GoodByte-Hardware/BTZ-EndDevice/kibot_resources/templates/readme.txt

<p align="center" width="100%">
  
</p>

<h1 align="center">${BOARD_NAME}</h1>

<p align="center" width="100%">
  <a href="${GIT_URL}/actions/workflows/ci.yaml">
    CI Badge
  </a>
</p>

***

<p align="center">
  3D Top Angled
&nbsp; &nbsp; &nbsp; &nbsp;
  3D Bottom Angled
</p>

***

## SPECIFICATIONS

| Parameter | Value | 
| --- | --- |
| Dimensions | ${bb_w_mm} × ${bb_h_mm} mm |

***

## DIRECTORY STRUCTURE

    .
    ├─ HTML               # HTML files for generated webpage
    ├─ Images             # Pictures and renders
    │
    ├─ kibot_resources    # External resources for KiBot
    │  ├─ colors          # Color theme for KiCad
    │  ├─ fonts           # Fonts used in the project
    │  ├─ scripts         # External scripts used with KiBot
    │  └─ templates       # Templates for KiBot generated reports
    │
    ├─ kibot_yaml         # KiBot YAML config files
    ├─ KiRI               # KiRI (PCB diff viewer) files
    │
    ├─ Library         	  # KiCad footprint and symbol libraries
    │  ├─ 3D Model       # Component 3D models
    │  ├─ Footprint      # Footprint libraries
    │  └─ Symbol         # Symbol libraries
    │
    ├─ Logos              # Logos
    │
    ├─ Manufacturing      # Assembly and fabrication documents
    │  ├─ Assembly        # Assembly documents (BoM, pos, notes)
    │  │
    │  └─ Fabrication     # Fabrication documents (ZIP, notes)
    │     ├─ Drill Tables # CSV drill tables
    │     └─ Gerbers      # Gerbers
    │
    ├─ Report             # Reports for ERC/DRC
    ├─ Schematic          # PDF of schematic
    ├─ Templates          # Title block templates
    ├─ Testing
    │  └─ Testpoints      # Testpoints tables      
    │
    └─ Variants           # Outputs for assembly variants
