GoodByte-Hardware/BTZ-EndDevice/HTML/images/cat_pdf_drill_map_BTZ-EndDevice-NPTH_drill_map.png

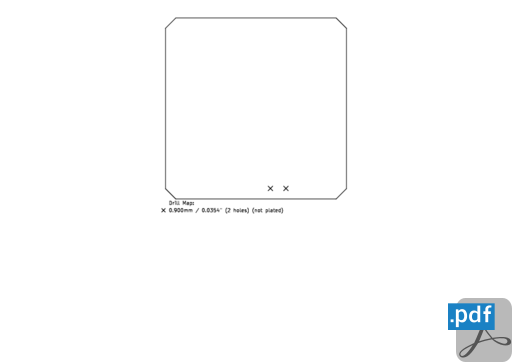
HTML/images/cat_pdf_drill_map_BTZ-EndDevice-NPTH_drill_map.png
