GoodByte-Hardware/BTZ-EndDevice/HTML/images/cat_pdf_schematic_BTZ-EndDevice-schematic.png

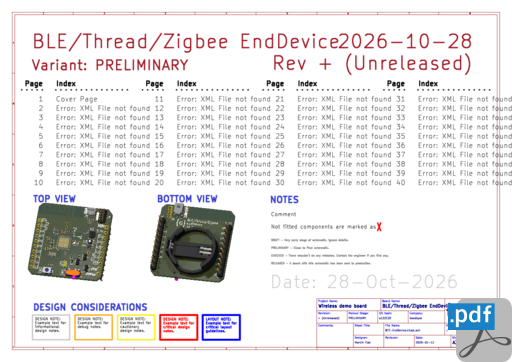
HTML/images/cat_pdf_schematic_BTZ-EndDevice-schematic.png
