GoodByte-Hardware/BTZ-EndDevice/HTML/images/cat_png_3d_viewer_bottom_BTZ-EndDevice-bottom.png

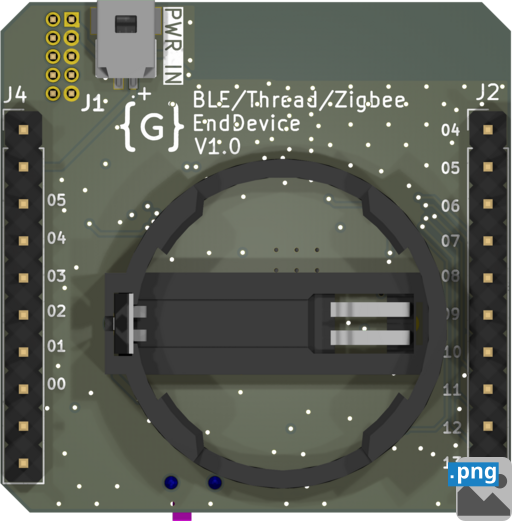
HTML/images/cat_png_3d_viewer_bottom_BTZ-EndDevice-bottom.png
