GoodByte-Hardware/BTZ-EndDevice/HTML/images/cat_png_3d_viewer_top_BTZ-EndDevice-top.png

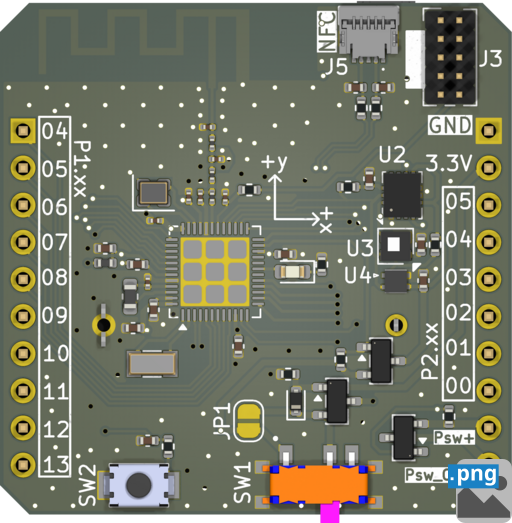
HTML/images/cat_png_3d_viewer_top_BTZ-EndDevice-top.png
