GoodByte-Hardware/BTZ-EndDevice/Manufacturing/Assembly/BTZ-EndDevice-bom.html

 | Bill of Materials
 | Schematic: BTZ-EndDevice Variant: PRELIMINARY Revision: + (Unreleased) Date: 2025-01-12 KiCad Version: 9.0.7+1 | Component Groups: 33 Component Count: 50 (per PCB) Fitted Components: 50 (per PCB) Number of PCBs: 1 Total Components: 50 (for 1 PCBs)
Row | Quantity Per PCB | References | Value | Datasheet | Footprint | Description | Manufacturer | Manufacturer Part Number | Supplier Part Number
1 | 1 | C12 | 0.3pF | ~ | C_0201_0603Metric | Unpolarized capacitor
2 | 1 | C11 | 2pF | ~ | C_0201_0603Metric | Unpolarized capacitor
3 | 1 | C10 | 1,5pF | ~ | C_0201_0603Metric | Unpolarized capacitor
4 | 1 | C14 | 3,9pF | ~ | C_0201_0603Metric | Unpolarized capacitor
5 | 2 | C17 C19 | 300pF | ~ | C_0402_1005Metric | Unpolarized capacitor
6 | 2 | C7 C18 | 10nF | ~ | C_0402_1005Metric | Unpolarized capacitor
7 | 1 | C6 | 2,2nF | ~ | C_0201_0603Metric | Unpolarized capacitor
8 | 7 | C2 C3 C4 C5 C13 C15 C16 | 100nF | ~ | C_0402_1005Metric | Unpolarized capacitor
9 | 1 | C1 | 10μF | ~ | C_0402_1005Metric | Unpolarized capacitor
10 | 2 | C8 C9 | 2,2μF | ~ | C_0402_1005Metric | Unpolarized capacitor
11 | 1 | D1 | D_Schottky | ~ | D_SOD-523 | Schottky diode
12 | 1 | D2 | LED | ~ | LED_0603_1608Metric | Light emitting diode
13 | 1 | FB1 | 120R@100MHz | ~ | L_0402_1005Metric | Ferrite bead
14 | 2 | J1 J3 | Conn_01x02_MountingPin | ~ | 2035580207 | Generic connectable mounting pin connector, single row, 01x02, script generated (kicad-library-utils/schlib/autogen/connector/) Cortex Debug Connector, standard ARM Cortex-M SWD and JTAG interface |  | A1001WR-S-2P
15 | 1 | J5 | Conn_01x05_MountingPin | ~ | 59453051110ECHLF | Generic connectable mounting pin connector, single row, 01x05, script generated (kicad-library-utils/schlib/autogen/connector/) | Amphenol FCI | 59453-051110ECHLF
16 | 1 | L2 | 2,7nH | ~ | L_0201_0603Metric | Inductor
17 | 2 | L3 L4 | 3,5nH | ~ | L_0201_0603Metric | Inductor
18 | 1 | L1 | 4,7μH | ~ | L_0603_1608Metric | Inductor
19 | 3 | Q1 Q2 Q3 | AO3401A | http://www.aosmd.com/pdfs/datasheet/AO3401A.pdf | SOT-23 | -4.0A Id, -30V Vds, P-Channel MOSFET, SOT-23
20 | 2 | R8 R10 | 0R | ~ | R_0402_1005Metric | Resistor
21 | 2 | R6 R9 | 1k | ~ | R_0402_1005Metric | Resistor
22 | 2 | R4 R5 | 10k | ~ | R_0402_1005Metric | Resistor
23 | 1 | R3 | 3,3k | ~ | R_0402_1005Metric | Resistor
24 | 2 | R1 R7 | 470k | ~ | R_0402_1005Metric | Resistor
25 | 1 | R2 | 1M | ~ | R_0402_1005Metric | Resistor
26 | 1 | SW1 | SW_SPDT | ~ | SSSS810701 | Switch, single pole double throw
27 | 1 | SW2 | SW_SPST | ~ | SW_TS-1088-AR02016 | Single Pole Single Throw (SPST) switch
28 | 1 | U2 | BMI270 | https://www.bosch-sensortec.com/media/boschsensortec/downloads/datasheets/bst-bmi270-ds000.pdf | Bosch_LGA-14_3x2.5mm_P0.5mm | 6-axis, smart, low power Inertial Measurement Unit
29 | 1 | U4 | LTR-329ALS-01 | https://optoelectronics.liteon.com/upload/download/DS86-2014-0006/LTR-329ALS-01_DS_V1.pdf | Lite-On_LTR-329ALS-01 | ambient light sensor, i2c interface, 0.01 to 64k lux, 2.4-3.6V | Lite-On | LTR-329ALS-01
30 | 1 | U3 | STS4X | https://sensirion.com/media/documents/D2D0B4A9/67AA0F30/HT_DS_Datasheet_STS4x.pdf | STS4X | Digital Temperature Sensor, ±0.2 °C, Ultra-Low-Power, I2C fast mode plus
31 | 1 | U1 | nRF54L15-QFXX | https://docs.nordicsemi.com/bundle/ps_nrf54L15 | QFN-48-1EP_6x6mm_P0.4mm_EP4.6x4.6mm | nRF54L Dual Core Multiprotocol BLE SoC
32 | 1 | Y2 | 32.768kHz | ~ | Crystal_SMD_3215-2Pin_3.2x1.5mm | Two pin crystal
33 | 1 | Y1 | 32MHz | ~ | Crystal_SMD_2016-4Pin_2.0x1.6mm | Four pin crystal, GND on pins 2 and 4
Color reference for columns:
KiCad Fields (default)
Generated Fields
User Fields
Empty Fields
