GoodByte-Hardware/BTZ-EndDevice/Manufacturing/Assembly/BOM_V1.0.csv

Reference | Value | Footprint | LCSC
C4 | 100nF | Capacitor_SMD:C_0201_0603Metric | C76939
C6 | 2,2nF | Capacitor_SMD:C_0201_0603Metric | C161488
C9 | 2,2μF | Capacitor_SMD:C_0201_0603Metric | C335106
C10 | 1,5pF | Capacitor_SMD:C_0201_0603Metric | C88913
C11 | 2pF | Capacitor_SMD:C_0201_0603Metric | C668326
C12 | 0.3pF | Capacitor_SMD:C_0201_0603Metric | C3904589
C14 | 3,9pF | Capacitor_SMD:C_0201_0603Metric | C1852416
C1 | 10μF | Capacitor_SMD:C_0402_1005Metric | C15525
C2,C3,C5,C13,C15,C16 | 100nF | Capacitor_SMD:C_0402_1005Metric | C1525
C7,C18 | 10nF | Capacitor_SMD:C_0402_1005Metric | C15195
C8 | 2,2μF | Capacitor_SMD:C_0402_1005Metric | C12530
C17,C19 | 300pF | Capacitor_SMD:C_0402_1005Metric | C1534
J3 | Conn_ARM_JTAG_SWD_10 | Connector_PinHeader_1.27mm:PinHeader_2x05_P1.27mm_Vertical
Y1 | 32MHz | Crystal:Crystal_SMD_2016-4Pin_2.0x1.6mm | C187794
Y2 | 32.768kHz | Crystal:Crystal_SMD_3215-2Pin_3.2x1.5mm | C32346
D1 | D_Schottky | Diode_SMD:D_SOD-523 | C7502714
L2 | 2,7nH | Inductor_SMD:L_0201_0603Metric | C7216765
L3,L4 | 3,5nH | Inductor_SMD:L_0201_0603Metric | C3911055
FB1 | 120R@100MHz | Inductor_SMD:L_0402_1005Metric | C85812
L1 | 4,7μH | Inductor_SMD:L_0603_1608Metric | C76799
D2 | LED | LED_SMD:LED_0603_1608Metric | C965804
J1 | Conn_01x02_MountingPin | Library:2035580207 | C160402
J5 | Conn_01x05_MountingPin | Library:59453051110ECHLF
SW1 | SW_SPDT | Library:SSSS810701 | C97433
U3 | STS4X | Library:STS4X | C41410764
SW2 | SW_SPST | Library:SW_TS-1088-AR02016 | C720477
U1 | nRF54L15-QFXX | Package_DFN_QFN:QFN-48-1EP_6x6mm_P0.4mm_EP4.6x4.6mm
U2 | BMI270 | Package_LGA:Bosch_LGA-14_3x2.5mm_P0.5mm | C2836813
Q1,Q2,Q3 | AO3401A | Package_TO_SOT_SMD:SOT-23 | C15127
R1,R7 | 470k | Resistor_SMD:R_0402_1005Metric | C25790
R2 | 1M | Resistor_SMD:R_0402_1005Metric | C26083
R3 | 3,3k | Resistor_SMD:R_0402_1005Metric | C25890
R4,R5 | 10k | Resistor_SMD:R_0402_1005Metric | C25744
R6,R9 | 1k | Resistor_SMD:R_0402_1005Metric | C11702
R8,R10 | 0R | Resistor_SMD:R_0402_1005Metric | C17168
U4 | LTR-329ALS-01 | Library:Lite-On_LTR-329ALS-01 | C284894
