GoodByte-Hardware/BTZ-EndDevice/Testing/Testpoints/BTZ-EndDevice-testpoints-top.csv

Ref. | Net | X [mm] | Y [mm]
TP1 |  | -64.00 | 106.00
TP2 |  | -64.00 | 106.00
TP3 |  | -64.00 | 106.00
TP4 |  | -64.00 | 106.00
TP5 |  | -64.00 | 106.00
TP6 |  | -64.00 | 106.00
TP7 |  | -64.00 | 106.00
TP8 |  | -64.00 | 106.00
TP9 |  | -64.00 | 106.00
TP10 |  | -64.00 | 106.00
TP11 |  | -64.00 | 106.00
TP12 |  | -64.00 | 106.00
