GoodByte-Hardware/BTZ-EndDevice/3D/BTZ-EndDevice.step

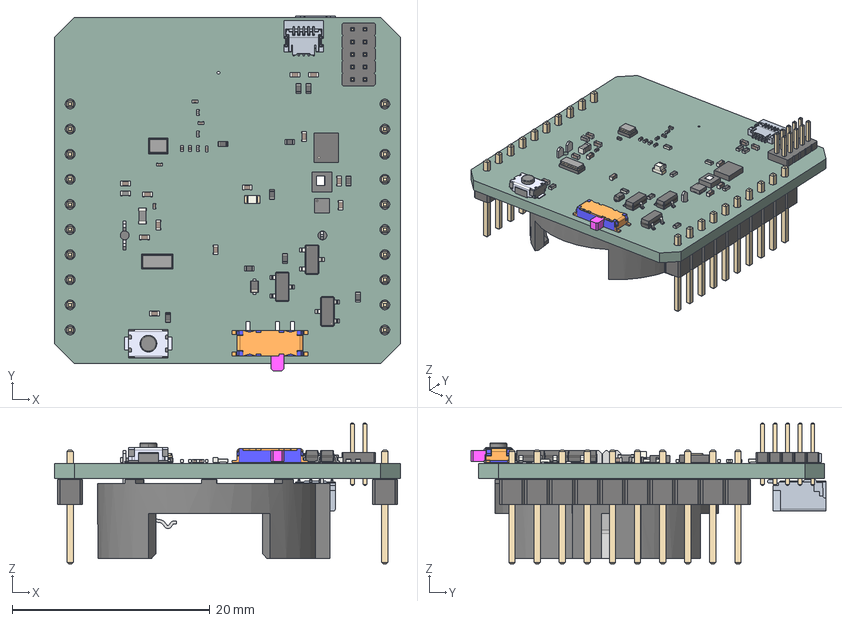
[picture p8: CAD file, 2026-10-28]
3D/BTZ-EndDevice.step
35.0 x 35.9 x 14.3 mm
D_SOD-523
STS4X
C_0402_1005Metric x 12
R_0402_1005Metric x 10
C_0201_0603Metric x 7
L_0201_0603Metric x 3
L_0603_1608Metric
L_0402_1005Metric
PinHeader_2x05_P1.27mm_Vertical
Crystal_SMD_3215-2Pin_3.2x1.5mm
LED_0603_1608Metric
59453-051110ECHLF
SOT-23 x 3
LTR-329ALS-01
Crystal_SMD_2016-4Pin_2.0x1.6mm
TS-1088-AR02016--3DModel-STEP-269445
Bosch_LGA-14_3x2.5mm_P0.5mm
SSSS811101
PinHeader_1x10_P2.54mm_Vertical x 2
DS1092-06-B6P
kibot_vaj51jym_PCB
