GoodByte-Hardware/BTZ-EndDevice/Manufacturing/Fabrication/BTZ-EndDevice-fabrication.pdf

# Layer Stack Legend

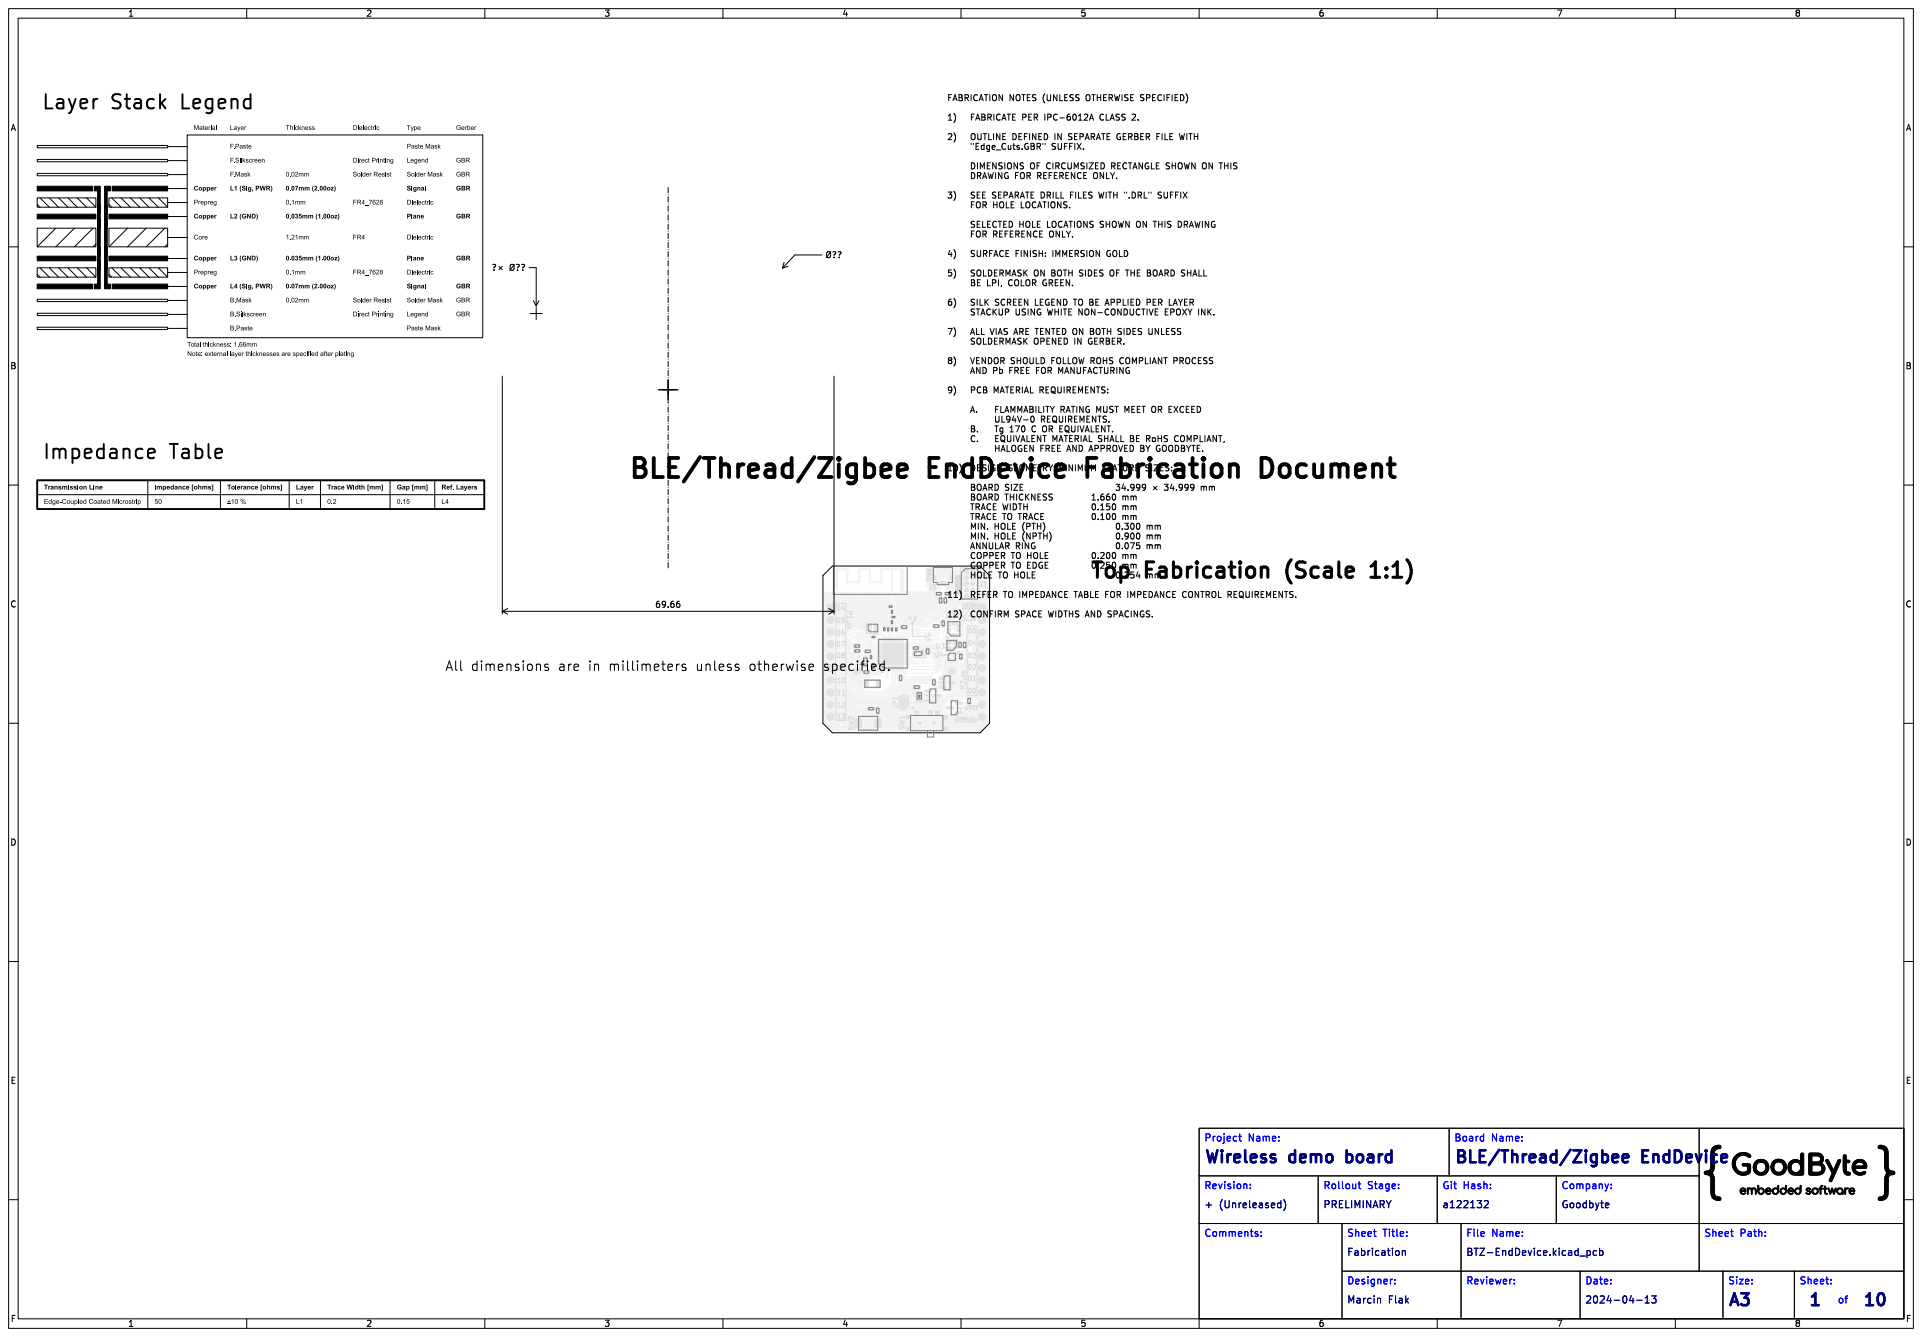
[picture p9: page 1]

FABRICATION NOTES (UNLESS OTHERWISE SPECIFIED)

1) FABRICATE PER IPC-6012A CLASS 2.

2) OUTLINE DEFINED IN SEPARATE GERBER FILE WITH
"Edge_Cuts.GBR" SUFFIX.

DIMENSIONS OF CIRCUMSIZED RECTANGLE SHOWN ON THIS
DRAWING FOR REFERENCE ONLY.

3) SEE SEPARATE DRILL FILES WITH ".DRL" SUFFIX
FOR HOLE LOCATIONS.

SELECTED HOLE LOCATIONS SHOWN ON THIS DRAWING
FOR REFERENCE ONLY.

4) SURFACE FINISH: IMMERSION GOLD

5) SOLDERMASK ON BOTH SIDES OF THE BOARD SHALL
BE LPI, COLOR GREEN.

6) SILK SCREEN LEGEND TO BE APPLIED PER LAYER
STACKUP USING WHITE NON-CONDUCTIVE EPOXY INK.

7) ALL VIAS ARE TENTED ON BOTH SIDES UNLESS
SOLDERMASK OPENED IN GERBER.

8) VENDOR SHOULD FOLLOW ROHS COMPLIANT PROCESS
AND Pb FREE FOR MANUFACTURING

A. FLAMMABILITY RATING MUST MEET OR EXCEED
UL94V-0 REQUIREMENTS.
B. Tg 170 C OR EQUIVALENT.
C. EQUIVALENT MATERIAL SHALL BE RoHS COMPLIANT,
HALOGEN FREE AND APPROVED BY GOODBYTE.

BLE/Thread/Zigbee EndDevice Fabrication Document

10) DESIGN GEOMETRY MINIMUM FEATURE SIZES:

BOARD SIZE 34.999 × 34.999 mm
BOARD THICKNESS 1.660 mm
TRACE WIDTH 0.150 mm
TRACE TO TRACE 0.100 mm
MIN. HOLE (PTH) 0.300 mm
MIN. HOLE (NPTH) 0.900 mm
ANNULAR RING 0.075 mm
COPPER TO HOLE 0.200 mm
COPPER TO EDGE 0.250 mm
HOLE TO HOLE 0.254 mm

Board Name:
BLE/Thread/Zigbee EndDevice

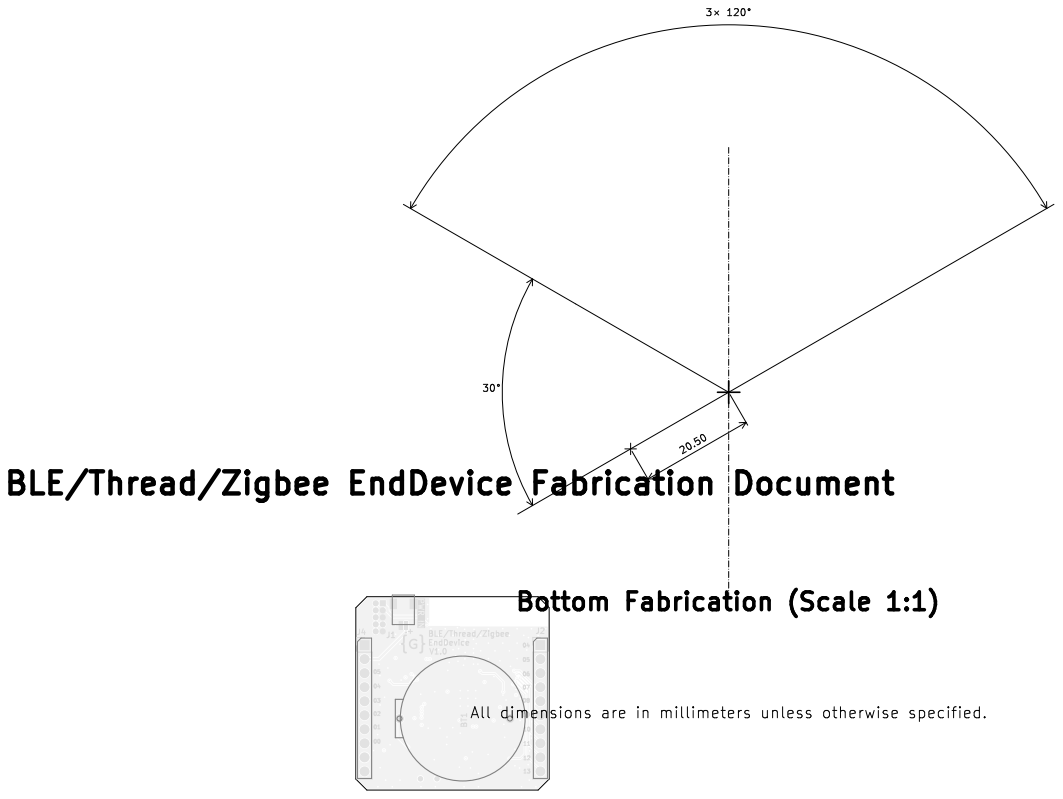
[picture p10: page 2]
+ (Unreleased); Fabrication; Git; Hash:; Sheet Title:; Project; Name:; Sheet Path:; PRELIMINARY; Goodbyte; Rollout Stage:; Company:; BTZ-EndDevice.kicad_pcb; Board; Revision:; Comments:; File; Bottom; Fabrication (Scale 1:1); BLE/Thread/Zigbee; EndDevice; Document; All; dimensions are in millimeters unless otherwise specified. BT1; BLE/Thread/Zigbee +

Wireless demo board

BLE/Thread/Zigbee EndDevice

# Drill Table

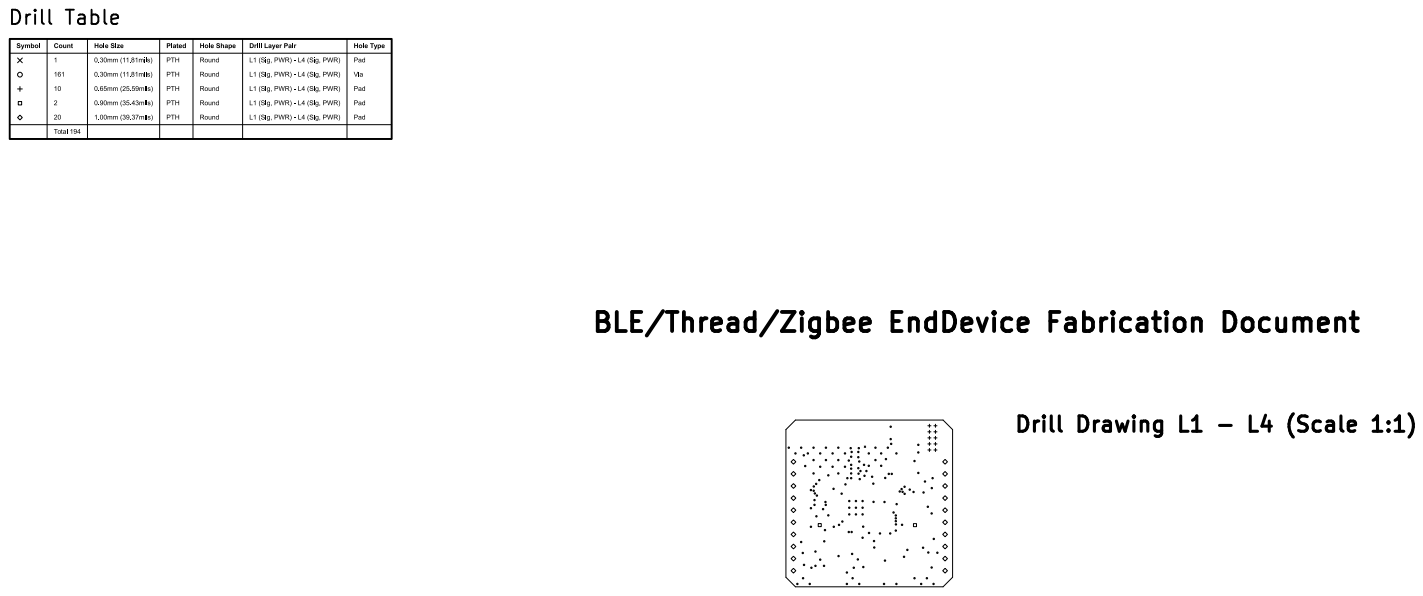
[picture p11: page 3]
+ (Unreleased); Fabrication; Git; Hash:; Sheet Title:; Project; Name:; Sheet Path:; PRELIMINARY; Goodbyte; Rollout Stage:; Company:; BTZ-EndDevice.kicad_pcb; Board; Revision:; Comments:; File; Drill; Drawing; L1 - L4 (Scale 1:1); BLE/Thread/Zigbee; EndDevice; Document

Wireless demo board

BLE/Thread/Zigbee EndDevice

# Drill Table

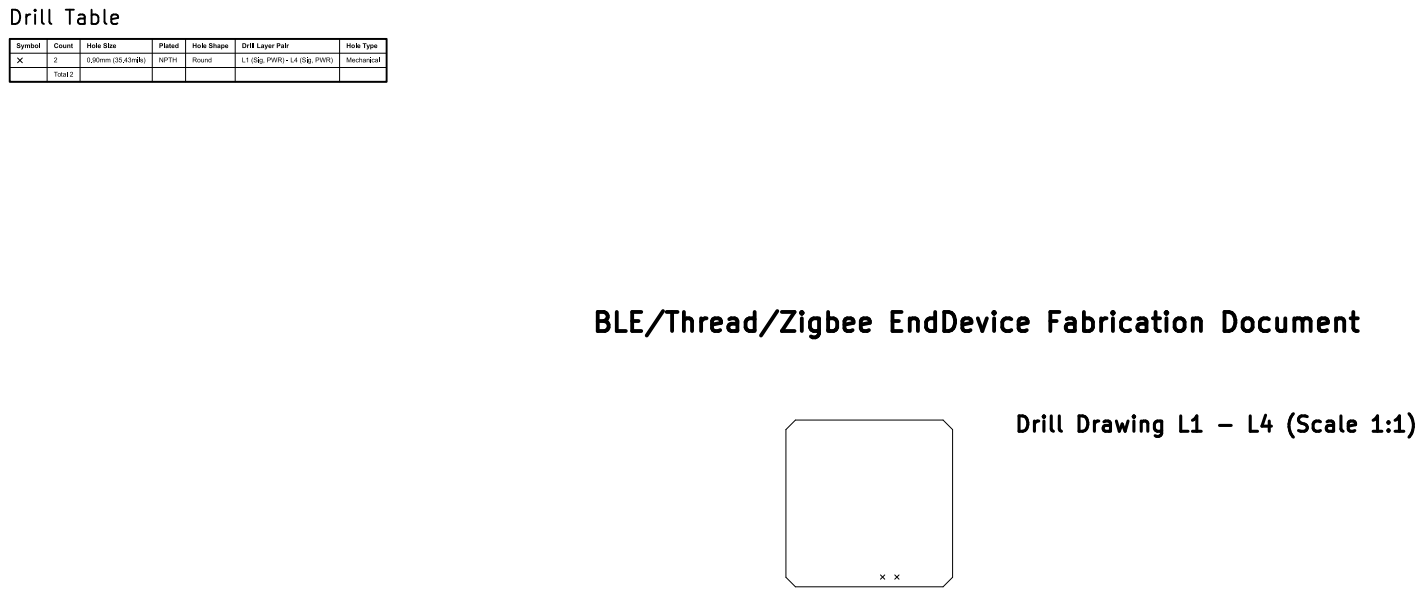
[picture p12: page 4]
+ (Unreleased); Fabrication; Git; Hash:; Sheet Title:; Project; Name:; Sheet Path:; PRELIMINARY; Goodbyte; Rollout Stage:; Company:; BTZ-EndDevice.kicad_pcb; Board; Revision:; Comments:; File; Drill; Drawing; L1 - L4 (Scale 1:1); BLE/Thread/Zigbee; EndDevice; Document

Wireless demo board

BLE/Thread/Zigbee EndDevice

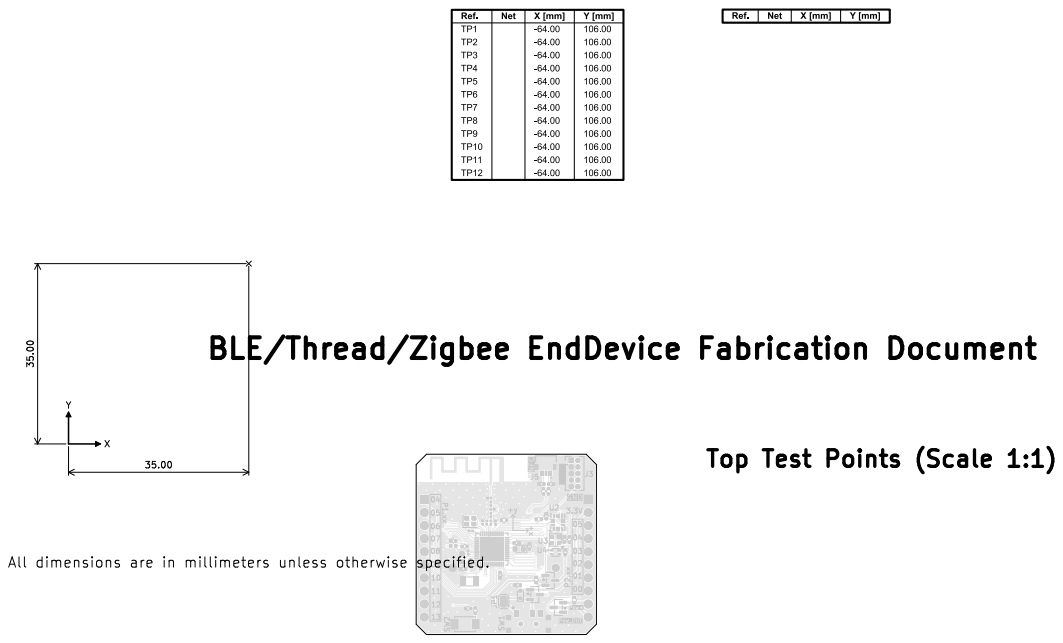
[picture p13: page 5]

Board Name:
BLE/Thread/Zigbee EndDevice

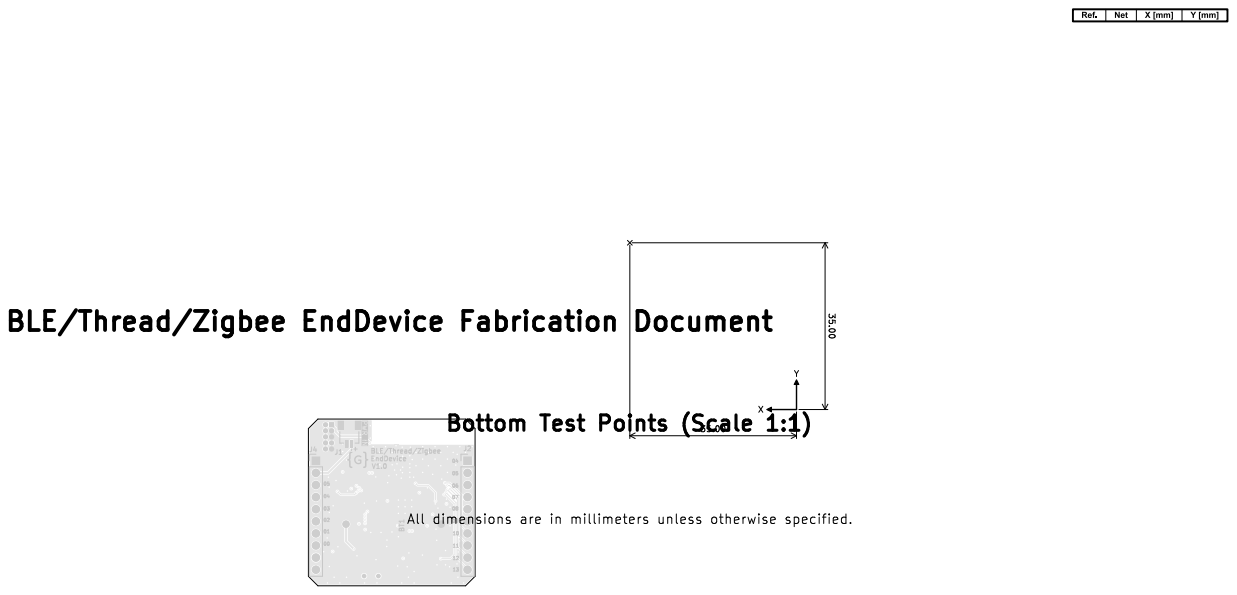
[picture p14: page 6]
+ (Unreleased); Fabrication; Git; Hash:; Sheet Title:; Project; Name:; Sheet Path:; PRELIMINARY; Goodbyte; Rollout Stage:; Company:; BTZ-EndDevice.kicad_pcb; Board; Revision:; Comments:; File; Bottom; Test; Points (Scale 1:1); BLE/Thread/Zigbee; EndDevice; Document; All; dimensions are in millimeters unless otherwise specified. BT1; BLE/Thread/Zigbee +

Wireless demo board

BLE/Thread/Zigbee EndDevice

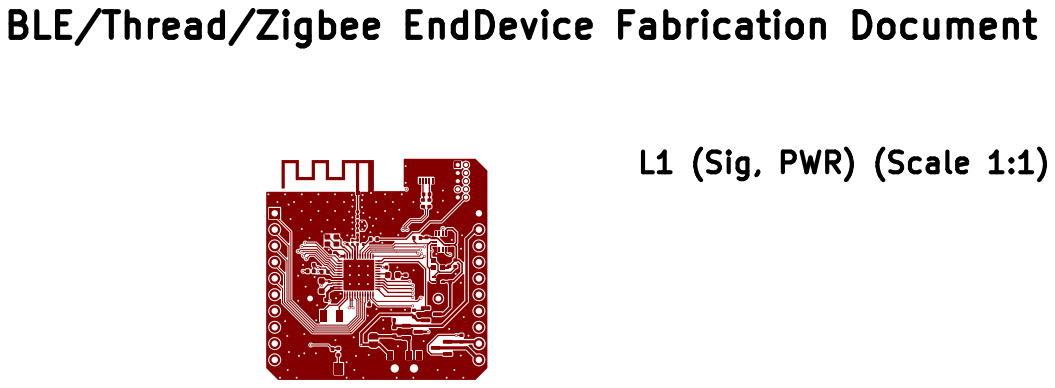
[picture p15: page 7]
+ (Unreleased); Fabrication; Git; Hash:; Sheet Title:; Project; Name:; Sheet Path:; PRELIMINARY; Goodbyte; Rollout Stage:; Company:; BTZ-EndDevice.kicad_pcb; Board; Revision:; Comments:; File; L1 (Sig,; PWR) (Scale 1:1); BLE/Thread/Zigbee; EndDevice; Document

Wireless demo board

BLE/Thread/Zigbee EndDevice

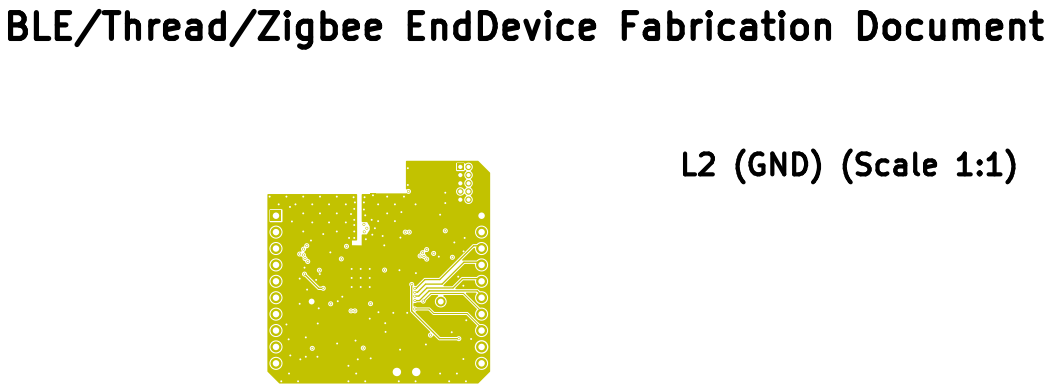
[picture p16: page 8]
+ (Unreleased); Fabrication; Git; Hash:; Sheet Title:; Project; Name:; Sheet Path:; PRELIMINARY; Goodbyte; Rollout Stage:; Company:; BTZ-EndDevice.kicad_pcb; Board; Revision:; Comments:; File; L2 (GND) (Scale 1:1); BLE/Thread/Zigbee; EndDevice; Document

Wireless demo board

BLE/Thread/Zigbee EndDevice

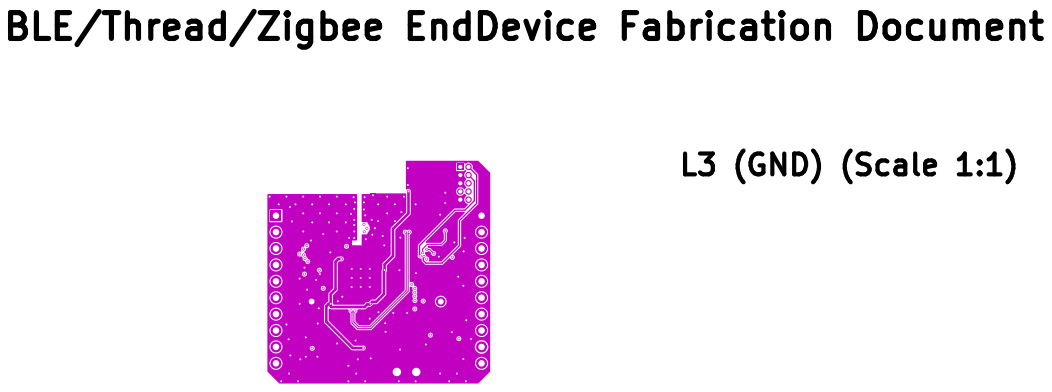
[picture p17: page 9]
+ (Unreleased); Fabrication; Git; Hash:; Sheet Title:; Project; Name:; Sheet Path:; PRELIMINARY; Goodbyte; Rollout Stage:; Company:; BTZ-EndDevice.kicad_pcb; Board; Revision:; Comments:; File; L3 (GND) (Scale 1:1); BLE/Thread/Zigbee; EndDevice; Document

Wireless demo board

BLE/Thread/Zigbee EndDevice

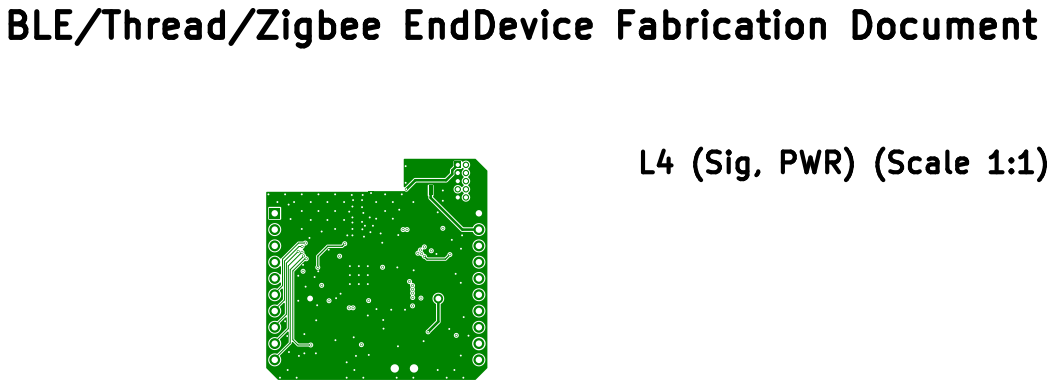
[picture p18: page 10]
+ (Unreleased); Fabrication; Git; Hash:; Sheet Title:; Project; Name:; Sheet Path:; PRELIMINARY; Goodbyte; Rollout Stage:; Company:; BTZ-EndDevice.kicad_pcb; Board; Revision:; Comments:; File; (Sig,; PWR) (Scale 1:1); BLE/Thread/Zigbee; EndDevice; Document

Wireless demo board

BLE/Thread/Zigbee EndDevice
