GoodByte-Hardware/BTZ-EndDevice/Manufacturing/Fabrication/BTZ-EndDevice-impedance_table.csv

Transmission Line | Impedance [ohms] | Tolerance [ohms] | Layer | Trace Width [mm] | Gap [mm] | Ref. Layers
Edge-Coupled Coated Microstrip | 50 | ±10 % | L1 | 0.2 | 0.15 | L4
