GoodByte-Hardware/BTZ-EndDevice/Manufacturing/Fabrication/Drill Tables/BTZ-EndDevice-(L1-L4)_drill_table.csv

Count | Hole Size | Plated | Hole Shape | Drill Layer Pair | Hole Type
1 | 0.30mm (11.81mils) | PTH | Round | L1 (Sig, PWR) - L4 (Sig, PWR) | Pad
161 | 0.30mm (11.81mils) | PTH | Round | L1 (Sig, PWR) - L4 (Sig, PWR) | Via
10 | 0.65mm (25.59mils) | PTH | Round | L1 (Sig, PWR) - L4 (Sig, PWR) | Pad
2 | 0.90mm (35.43mils) | PTH | Round | L1 (Sig, PWR) - L4 (Sig, PWR) | Pad
20 | 1.00mm (39.37mils) | PTH | Round | L1 (Sig, PWR) - L4 (Sig, PWR) | Pad
Total 194
