GoodByte-Hardware/BTZ-EndDevice/Manufacturing/Fabrication/Drill Tables/BTZ-EndDevice-(L1-L4)_NPTH_drill_table.csv

Count | Hole Size | Plated | Hole Shape | Drill Layer Pair | Hole Type
2 | 0.90mm (35.43mils) | NPTH | Round | L1 (Sig, PWR) - L4 (Sig, PWR) | Mechanical
Total 2
