GoodByte-Hardware/BTZ-EndDevice/HTML/images/cat_pdf_assembly_BTZ-EndDevice-assembly.png

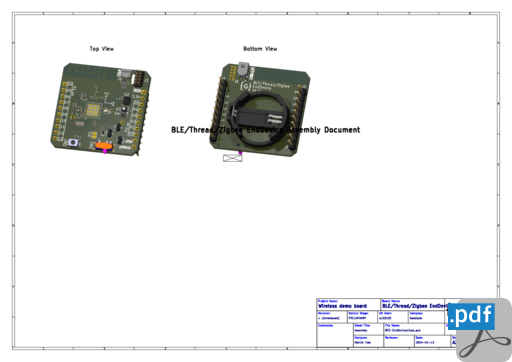
HTML/images/cat_pdf_assembly_BTZ-EndDevice-assembly.png
