GoodByte-Hardware/BTZ-EndDevice/HTML/images/cat_pdf_fabrication_BTZ-EndDevice-fabrication.png

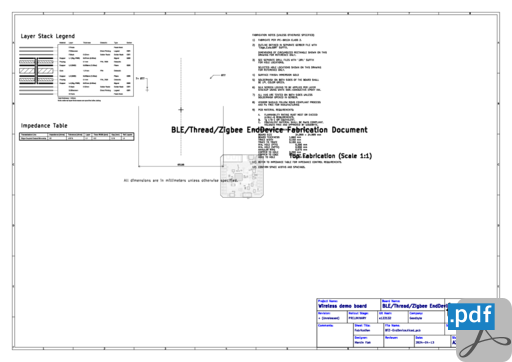
HTML/images/cat_pdf_fabrication_BTZ-EndDevice-fabrication.png
