GoodByte-Hardware/BTZ-EndDevice/Schematic/BTZ-EndDevice-schematic-1.pdf

# Variant: PRELIMINARY

# BLE/Thread/Zigbee EndDevice

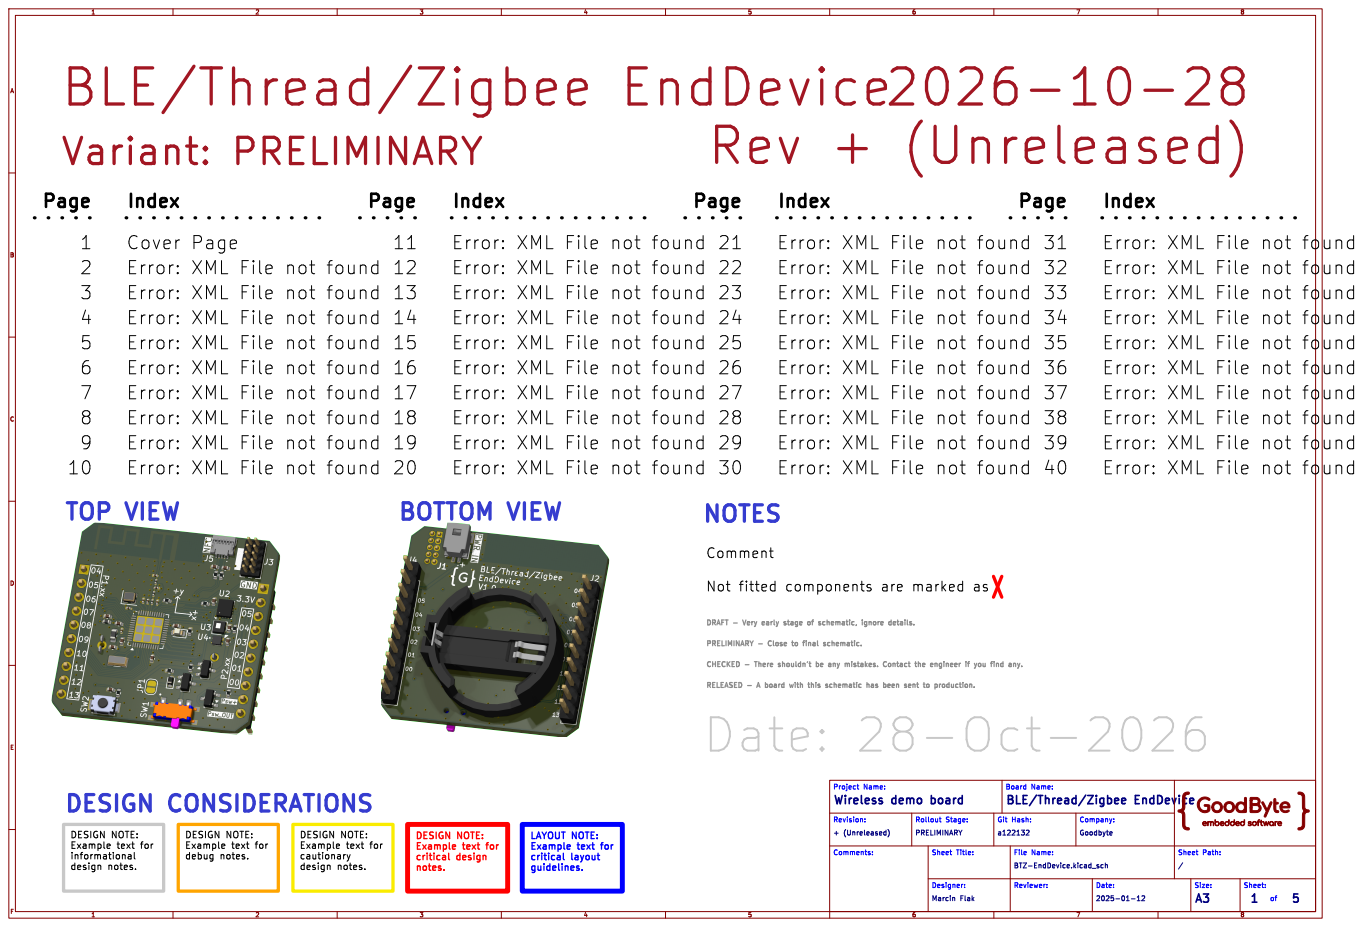
[picture p21: page 1]
Sheet: of; Size: A3; Revision: + (Unreleased); Project Name:; BTZ-EndDevice.kicad_sch Board; Name: Rollout Stage: PRELIMINARY; Company:; Goodbyte; Wireless demo; board; BLE/Thread/Zigbee; EndDevice; Sheet Title:; File Name:; / Comments:; Sheet Path: Git Hash: a122132 Reviewer:; Date: Marcin; Flak; 2025-01-12 Designer:; DESIGN; NOTE:; Example text; for; informational design notes.; cautionary design notes.; debug; notes.; kibot_image_png_3d_viewer_angled_top; LAYOUT NOTE: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

Cover Page
Error: XML File not found

BOTTOM VIEW

NOTES

DESIGN NOTE:
Example text for
critical design
notes.

critical layout
guidelines.
