GoodByte-Hardware/BTZ-EndDevice/Schematic/BTZ-EndDevice-schematic-2.pdf

[2] | Block | Diagram

## Page

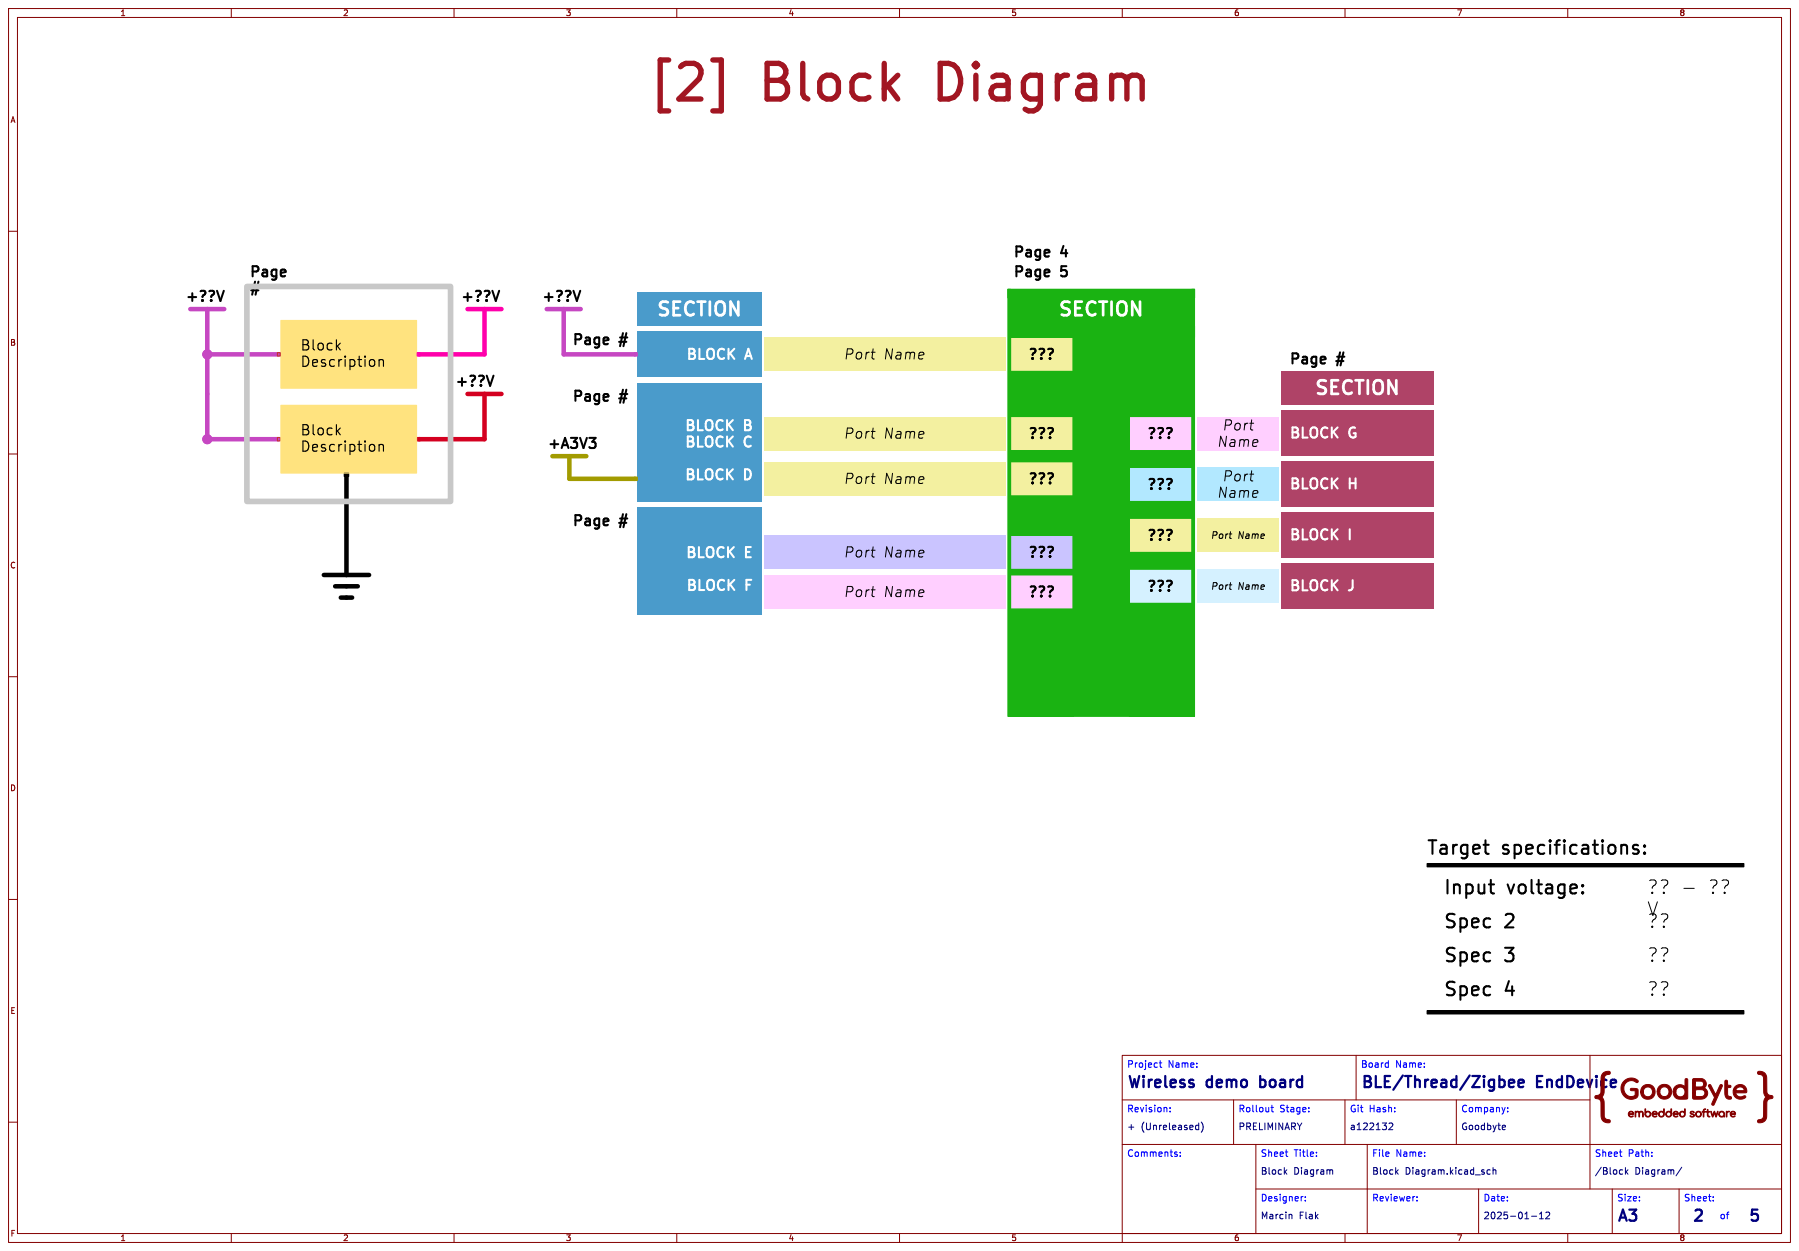
[picture p22: page 1]
Sheet: of; Size: A3; Revision: + (Unreleased); Project Name:; Block; Diagram.kicad_sch Board; Name: Rollout Stage: PRELIMINARY; Company:; Goodbyte; Wireless demo; board; BLE/Thread/Zigbee; EndDevice; Sheet Title:; File Name:; /Block; Diagram/ Sheet Path: Block; Diagram; Comments:; Git Hash: a122132 Reviewer:; Date: Marcin; Flak; 2025-01-12 Designer:; Port Name Port Name; Page #; BLOCK A; Port Name; SECTION; Spec 3; Target specifications:; Input voltage:; Spec 4; BLOCK J; BLOCK G; BLOCK; Spec 2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
