GoodByte-Hardware/BTZ-EndDevice/Schematic/BTZ-EndDevice-schematic-3.pdf

### Main

# [3] Project

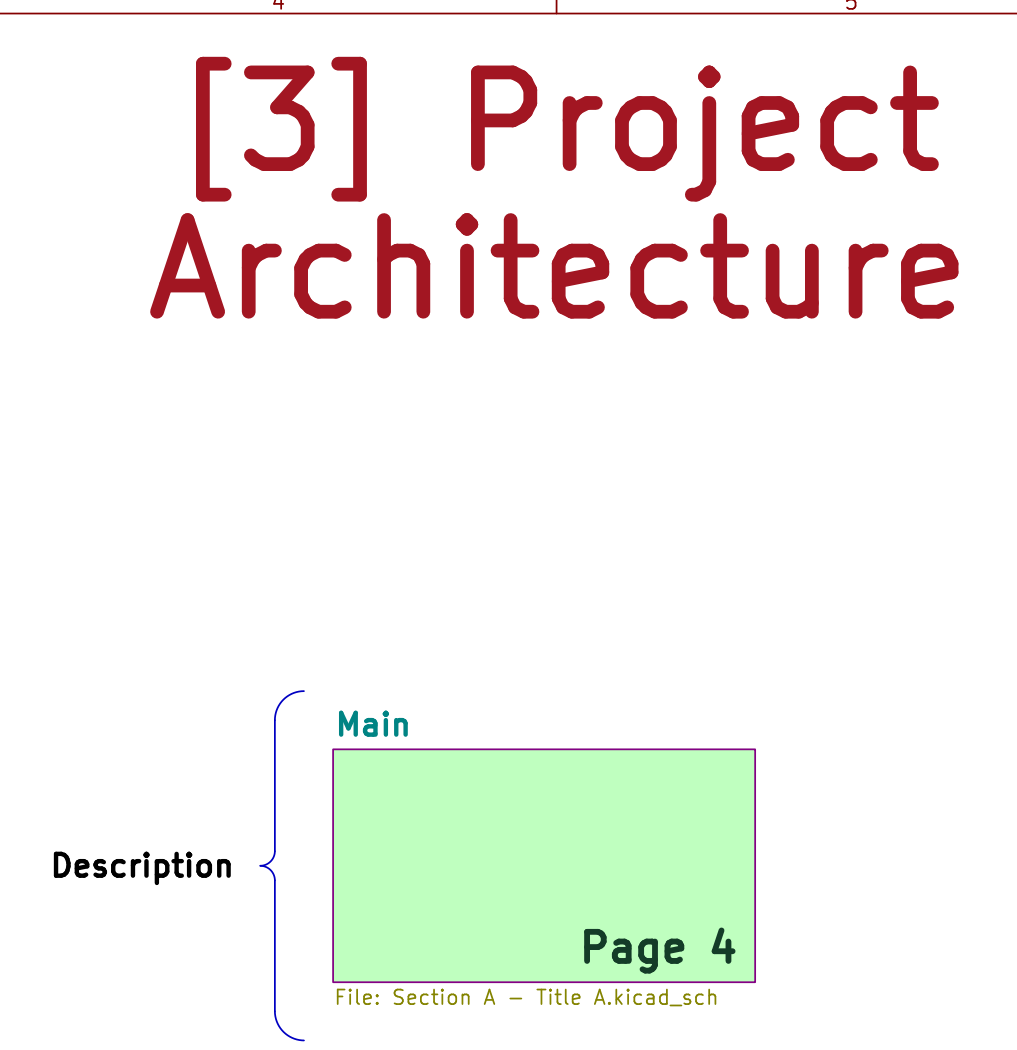
[picture p23: page 1]
Sheet: of; Size: A3; Revision: + (Unreleased); Project Name:; Project Architecture.kicad_sch Board; Name: Rollout Stage: PRELIMINARY; Company:; Goodbyte; Wireless demo; board; BLE/Thread/Zigbee; EndDevice; Sheet Title:; File Name:; /Project; Architecture/ Sheet Path: Project Architecture Comments:; Git Hash: a122132 Reviewer:; Date: Marcin; Flak; 2025-01-12 Designer:; Architecture; Page 4

File: Section A - Title A.kicad_sch Description
