GoodByte-Hardware/BTZ-EndDevice/Schematic/BTZ-EndDevice-schematic-4.pdf

# 100nFC9

XC1 34 XC2 35 P0.00 23 P0.01 24 P0.02 27 | VSS 44 | DECA 43 DECRF 33 DECD 45 DCC 46 ANT 31 ~{RESET} 30 SWDIO 25

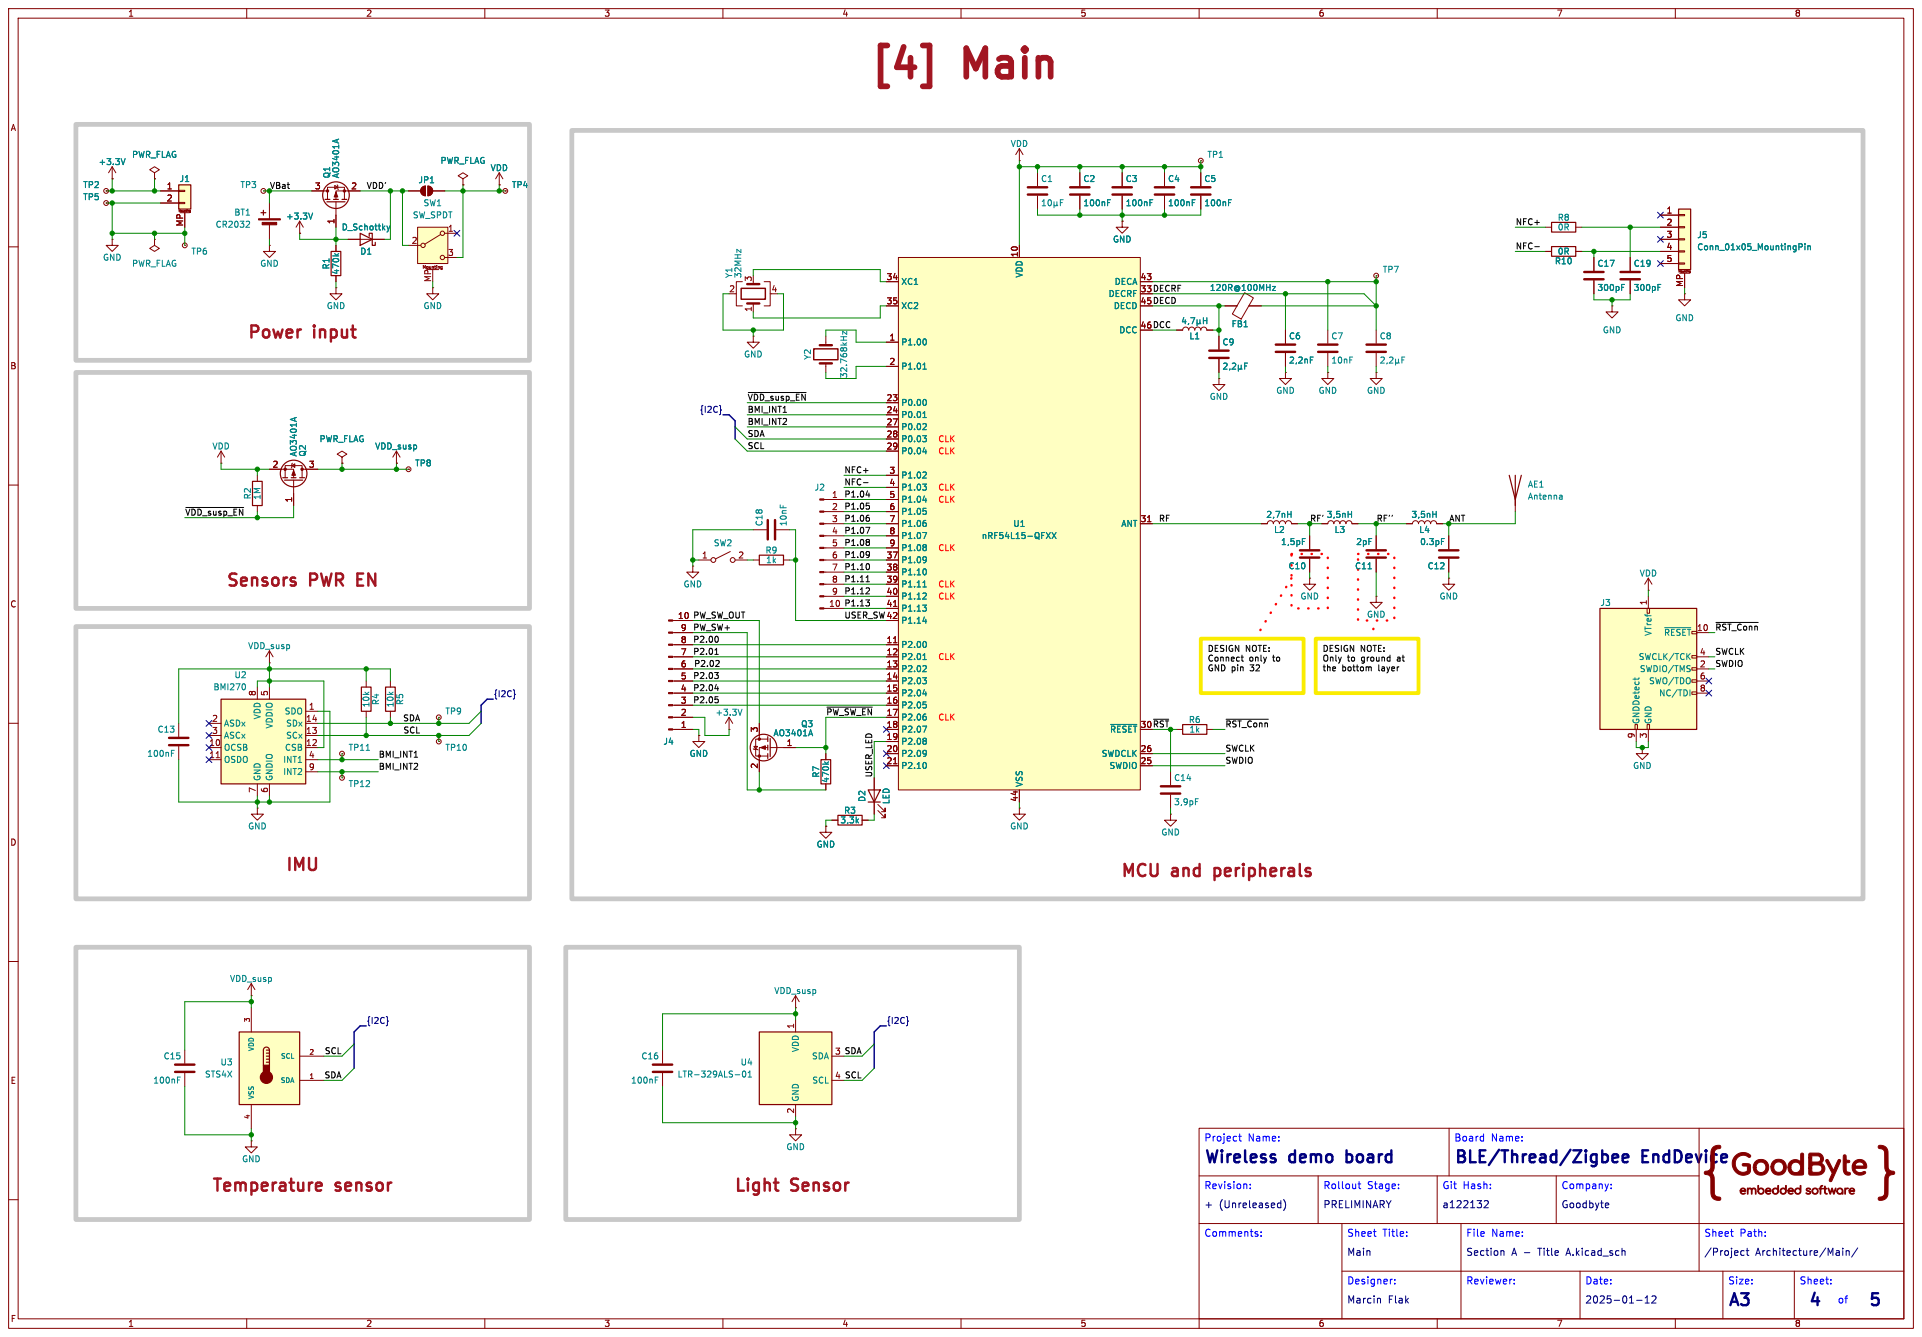
[picture p24: page 1]

CLK CLK CLK CLK CLK CLK CLK CLK CLK

7 ASDx 2 ASCx 3 OCSB 10 OSDO 11 U2 BMI270

5 GNDIO
SDO 1 SDx 14 SCx 13 CSB 12
INT2 9 VDDIO
