GoodByte-Hardware/BTZ-EndDevice/Schematic/BTZ-EndDevice-schematic-5.pdf

[5] | Revision | History

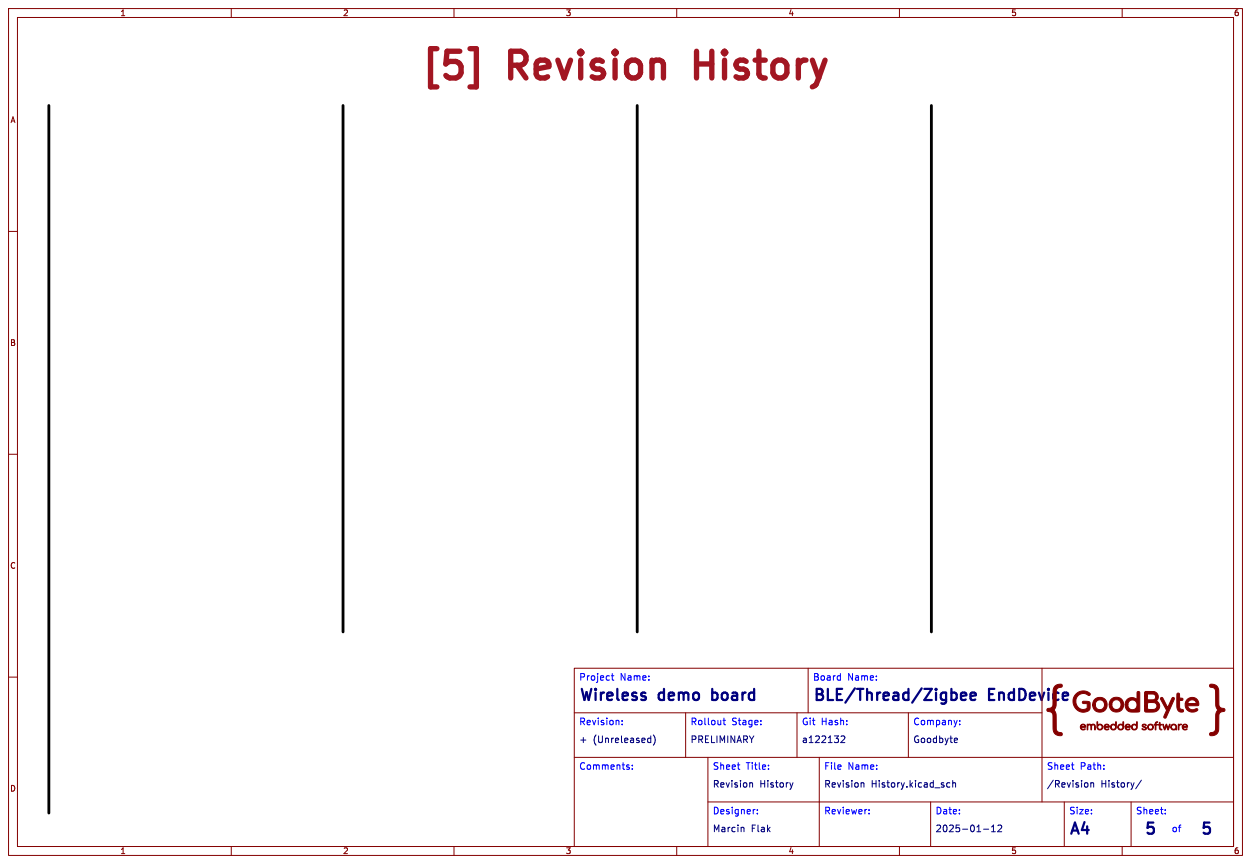
[picture p25: page 1]
Sheet: of; Size: A4; Revision: + (Unreleased); Project; Name:; Revision; History.kicad_sch Board; Name: Rollout Stage: PRELIMINARY; Company:; Goodbyte; Wireless demo; board; BLE/Thread/Zigbee; EndDevice; Sheet Title:; File; /Revision; History/ Sheet; Path: Revision; History Comments:; Git; Hash: a122132 Reviewer:; Date: Marcin Flak; 2025-01-12 Designer:
