GoodByte-Hardware/BTZ-EndDevice/Manufacturing/Assembly/BTZ-EndDevice-assembly-1.pdf

Top View | Bottom | View

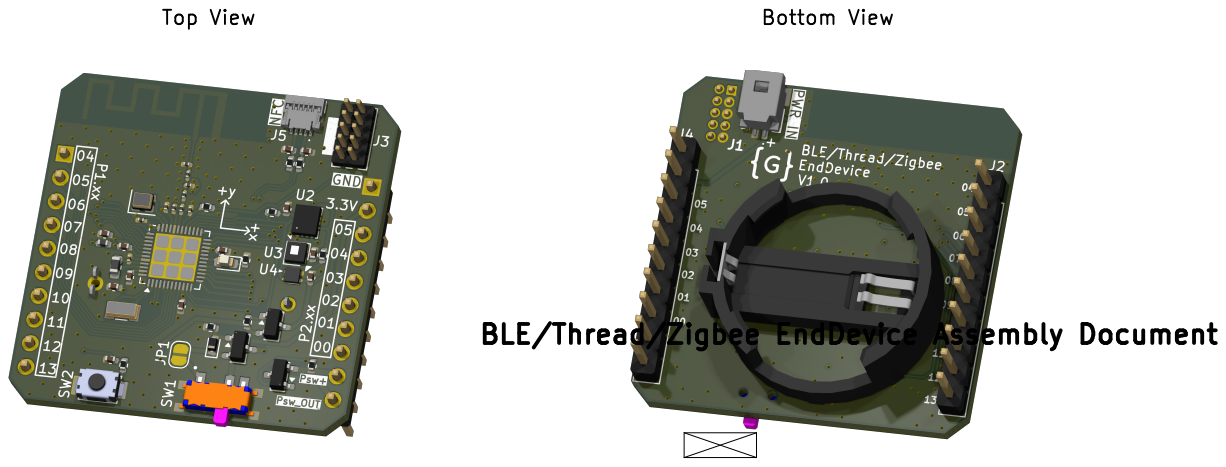
[picture p26: page 1]
+ (Unreleased); Assembly; Git; Hash:; Sheet Title:; Project; Name:; Sheet:; Sheet Path:; PRELIMINARY; Goodbyte; Size:; Rollout Stage:; Company:; BTZ-EndDevice.kicad_pcb; Board; Revision:; Comments:; Designer:; Reviewer:; Date:; Marcin Flak; File; Sheet: 1; BLE/Thread/Zigbee; EndDevice; Document

Wireless demo board

BLE/Thread/Zigbee EndDevice
