GoodByte-Hardware/BTZ-EndDevice/Manufacturing/Assembly/BTZ-EndDevice-assembly-3.pdf

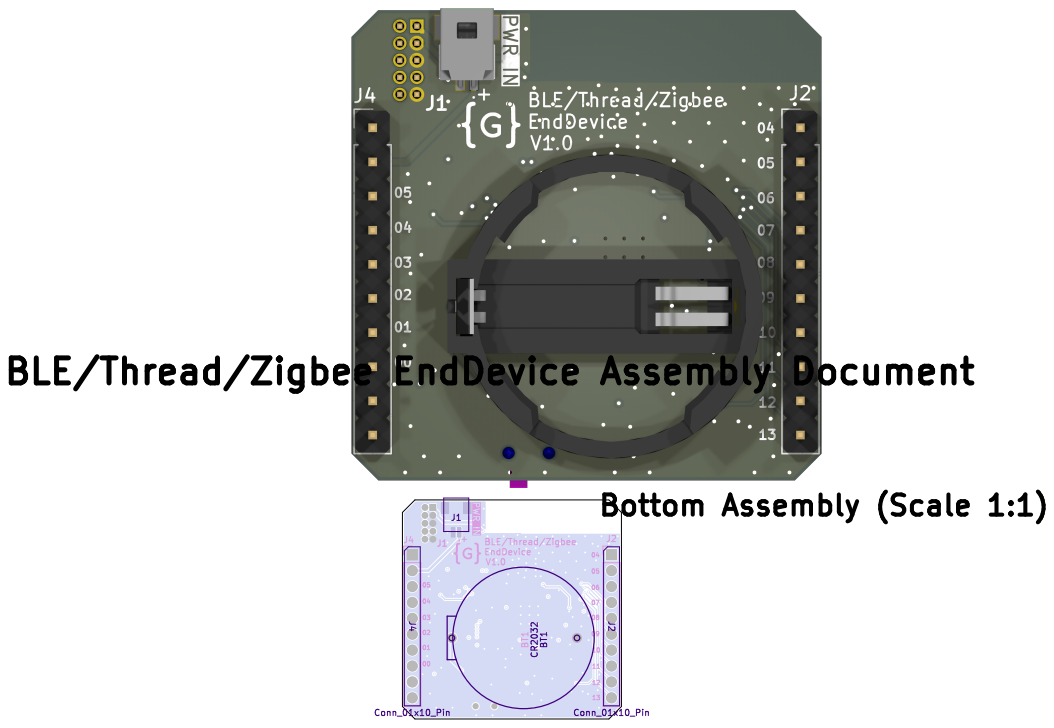
[picture p27: page 1]
+ (Unreleased); Assembly; Git; Hash:; Sheet Title:; Project; Name:; Sheet:; Sheet Path:; PRELIMINARY; Goodbyte; Size:; Rollout Stage:; Company:; BTZ-EndDevice.kicad_pcb; Board; Revision:; Comments:; Designer:; Reviewer:; Date:; Marcin Flak; File; Sheet: 3; Bottom; Assembly (Scale 1:1); BLE/Thread/Zigbee; EndDevice; Document; Conn_01x10_Pin; BLE/Thread/Zigbee +

Wireless demo board

BLE/Thread/Zigbee EndDevice
