GoodByte-Hardware/BTZ-EndDevice/Manufacturing/Assembly/BTZ-EndDevice-assembly.pdf

Top View | Bottom | View

+ (Unreleased); Assembly; Git; Hash:; Sheet Title:; Project; Name:; Sheet:; Sheet Path:; PRELIMINARY; Goodbyte; Size:; Rollout Stage:; Company:; BTZ-EndDevice.kicad_pcb; Board; Revision:; Comments:; Designer:; Reviewer:; Date:; Marcin Flak; File; BLE/Thread/Zigbee; EndDevice; Document

Wireless demo board

BLE/Thread/Zigbee EndDevice

# Components

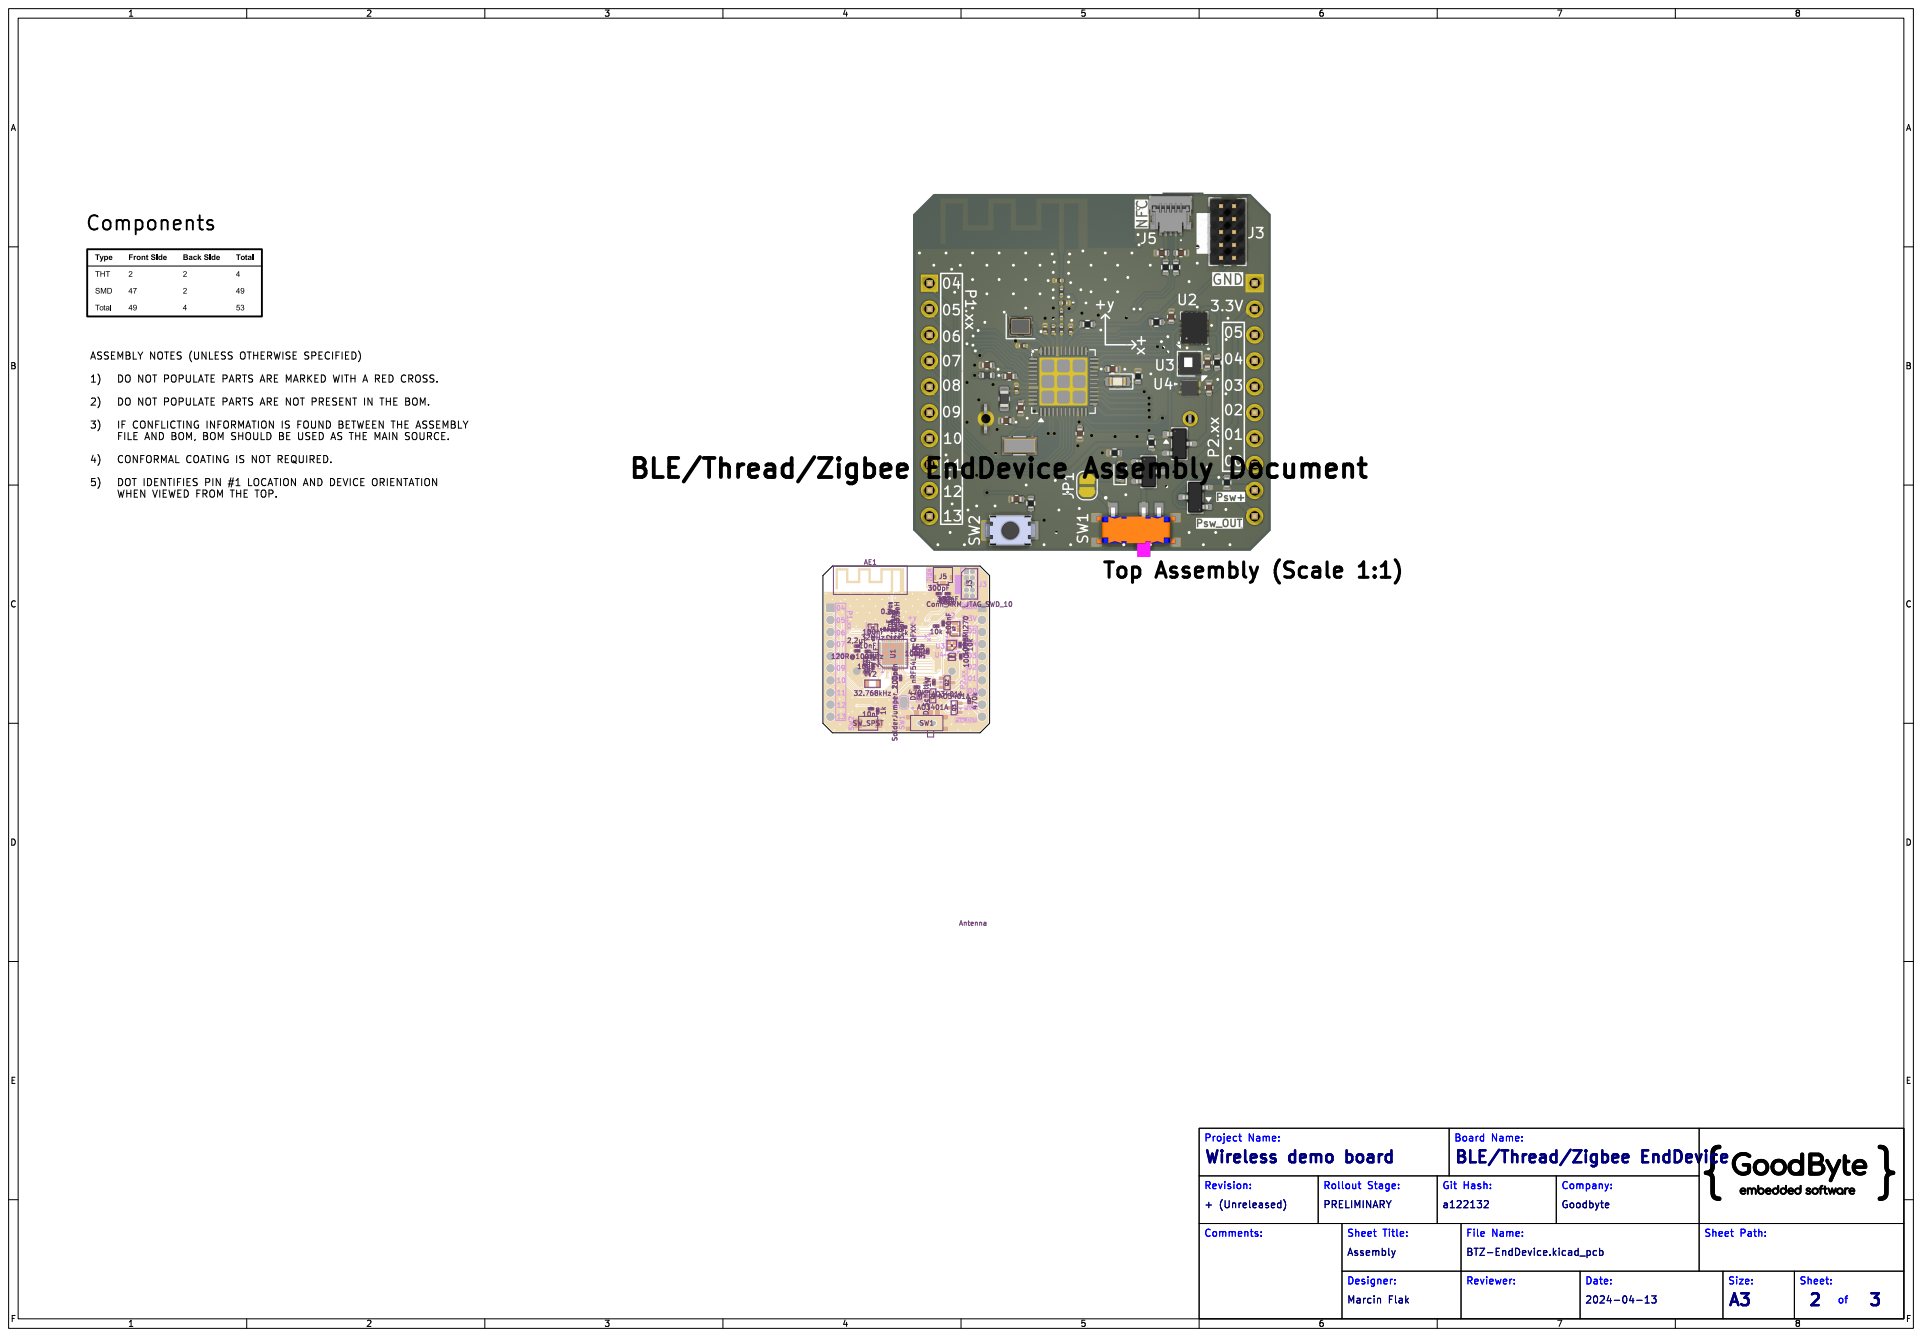
[picture p28: page 2]

ASSEMBLY NOTES (UNLESS OTHERWISE SPECIFIED)

1) DO NOT POPULATE PARTS ARE MARKED WITH A RED CROSS.

2) DO NOT POPULATE PARTS ARE NOT PRESENT IN THE BOM.

3) IF CONFLICTING INFORMATION IS FOUND BETWEEN THE ASSEMBLY
FILE AND BOM, BOM SHOULD BE USED AS THE MAIN SOURCE.

4) CONFORMAL COATING IS NOT REQUIRED.

BLE/Thread/Zigbee EndDevice Assembly Document

5) DOT IDENTIFIES PIN #1 LOCATION AND DEVICE ORIENTATION
WHEN VIEWED FROM THE TOP.

Board Name:
BLE/Thread/Zigbee EndDevice

+ (Unreleased); Assembly; Git; Hash:; Sheet Title:; Project; Name:; Sheet Path:; PRELIMINARY; Goodbyte; Rollout Stage:; Company:; BTZ-EndDevice.kicad_pcb; Board; Revision:; Comments:; File; Bottom; Assembly (Scale 1:1); BLE/Thread/Zigbee; EndDevice; Document; Conn_01x10_Pin; BLE/Thread/Zigbee +

Wireless demo board

BLE/Thread/Zigbee EndDevice
