GoodByte-Hardware/BTZ-EndDevice/Manufacturing/Fabrication/BTZ-EndDevice-fabrication-5.pdf

Board Name:
BLE/Thread/Zigbee EndDevice
