GoodByte-Hardware/BTZ-EndDevice/Schematic/BTZ-EndDevice-schematic.pdf

Cover Page
Error: XML File not found

BOTTOM VIEW

NOTES


??? | Port Name

Port Name | ??? | Port Name

BLOCK G

Port Name | ???

BLOCK J

Revision: + (Unreleased) | | Goodbyte

Diagram | /Block Diagram/ Sheet Path: Block


File: Section A - Title A.kicad_sch Description


CLK CLK CLK CLK CLK CLK CLK CLK CLK

7 ASDx 2 ASCx 3 OCSB 10 OSDO 11 U2 BMI270
