GoodByte-Hardware/BTZ-EndDevice/Manufacturing/Fabrication/Gerbers/BTZ-EndDevice-NPTH_drill_map.pdf

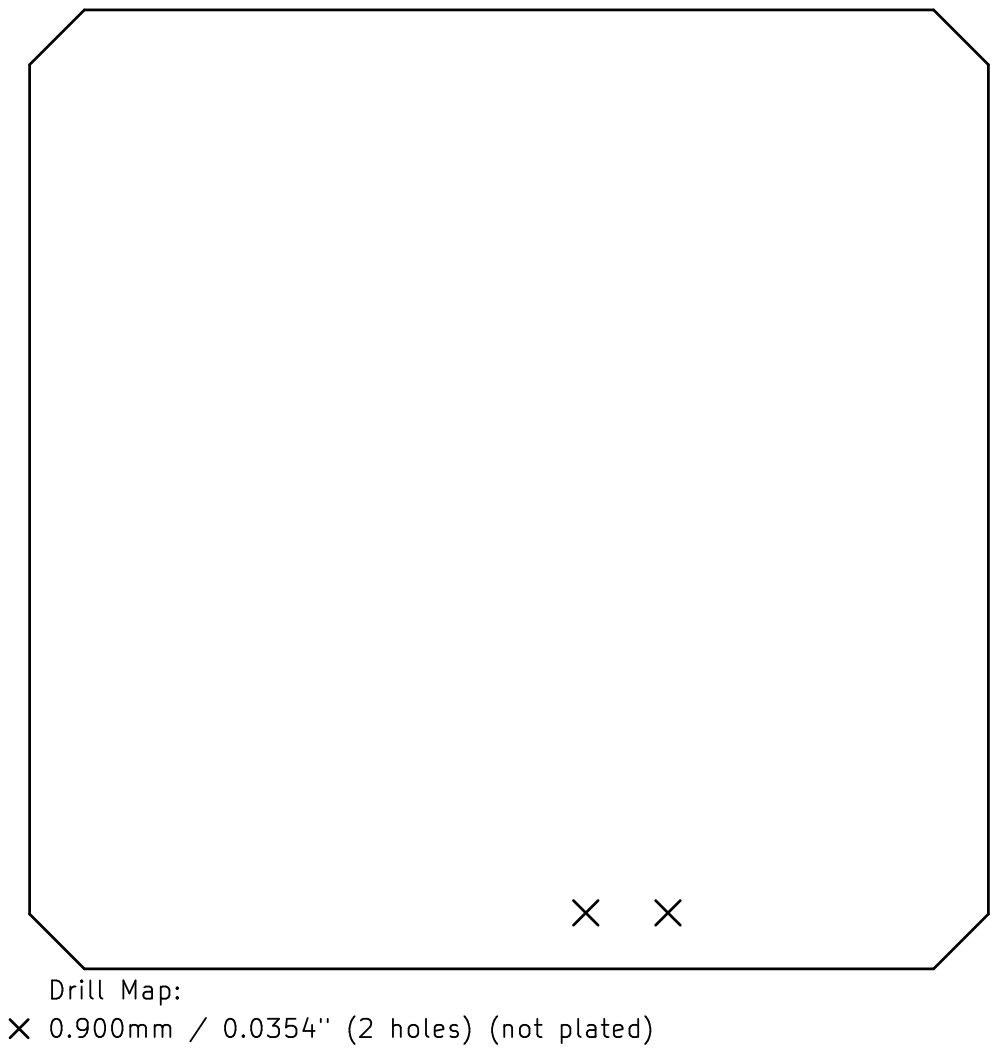
[picture p29: page 1]
