GoodByte-Hardware/BTZ-EndDevice/Manufacturing/Fabrication/Gerbers/BTZ-EndDevice-PTH_drill_map.pdf

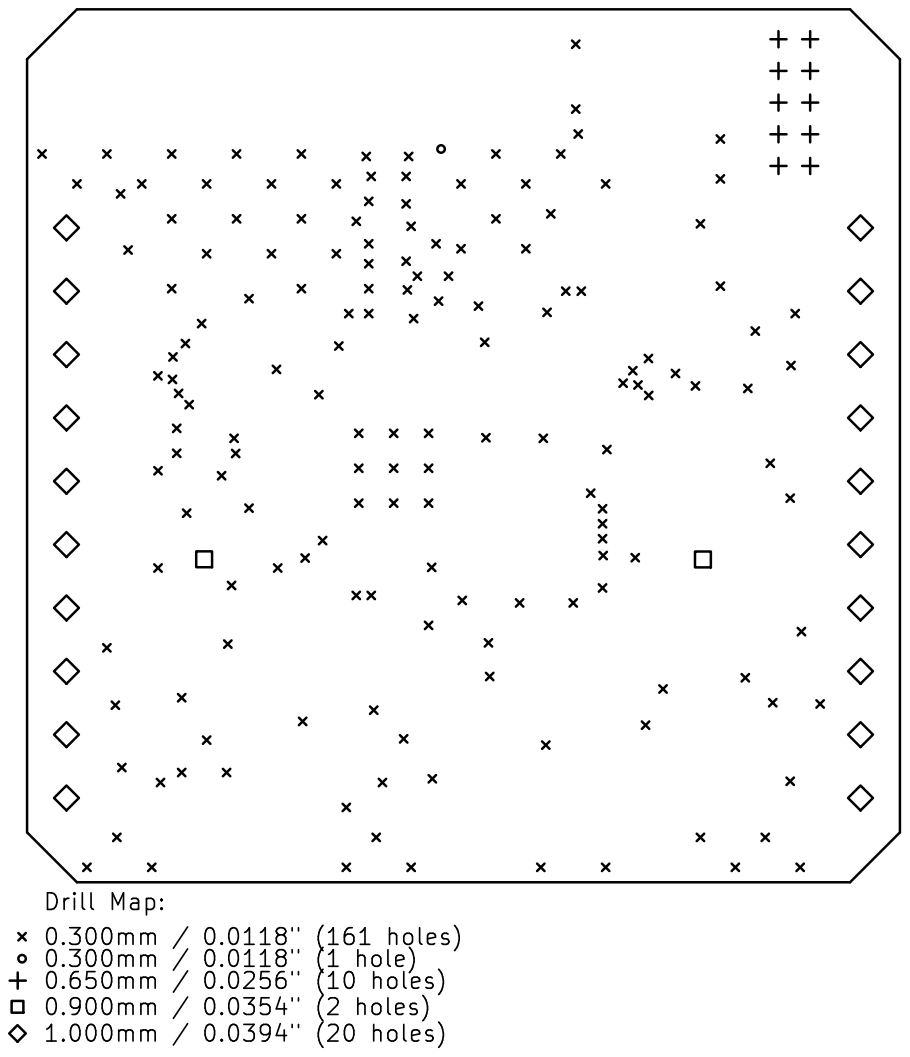
[picture p30: page 1]
