GoodByte-Hardware/BTZ-EndDevice/BTZ-EndDevice.kicad_pcb

## KiCad design BTZ-EndDevice.kicad_pcb (2026-10-28)

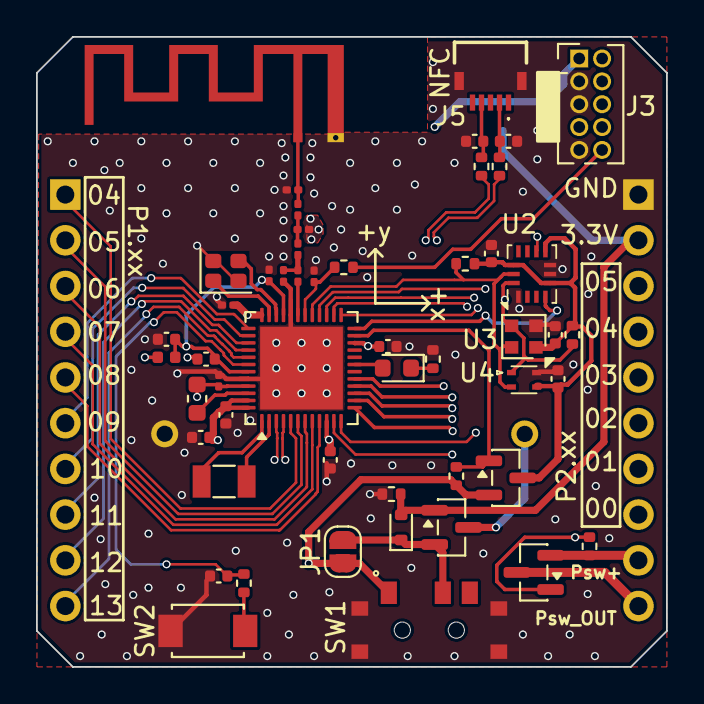
[picture p31: board BTZ-EndDevice.kicad_pcb from above]

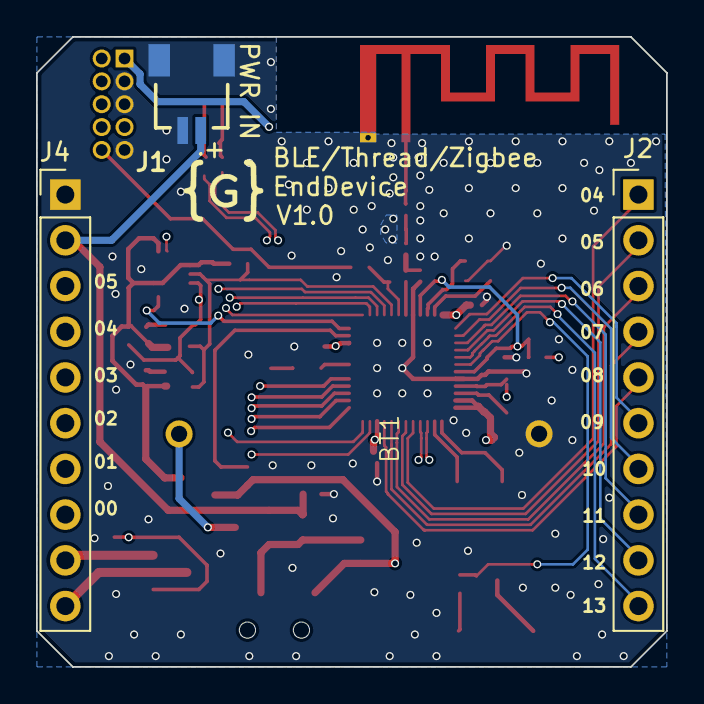
[picture p32: board BTZ-EndDevice.kicad_pcb from below]

Board: 4 copper layers, 35.0 x 35.0 mm, 55 parts (4 on the bottom side), 53 nets.

Parts:
AE1: Antenna; Texas_SWRA117D_2.4GHz_Left
BT1: CR2032; CR2032holder
C1: 10μF; C_0402_1005Metric
C2, C3, C5, C13, C15, C16: 100nF; C_0402_1005Metric
C4: 100nF; C_0201_0603Metric
C6: 2,2nF; C_0201_0603Metric
C7, C18: 10nF; C_0402_1005Metric
C8: 2,2μF; C_0402_1005Metric
C9: 2,2μF; C_0201_0603Metric
C10: 1,5pF; C_0201_0603Metric
C11: 2pF; C_0201_0603Metric
C12: 0.3pF; C_0201_0603Metric
C14: 3,9pF; C_0201_0603Metric
C17, C19: 300pF; C_0402_1005Metric
D1: D_Schottky; D_SOD-523
D2: LED; LED_0603_1608Metric
FB1: 120R@100MHz; L_0402_1005Metric
J1: Conn_01x02_MountingPin; 2035580207
J2, J4: Conn_01x10_Pin; PinHeader_1x10_P2.54mm_Vertical
J3: Conn_ARM_JTAG_SWD_10; PinHeader_2x05_P1.27mm_Vertical
J5: Conn_01x05_MountingPin; 59453051110ECHLF
JP1: SolderJumper_2_Open; SolderJumper-2_P1.3mm_Open_RoundedPad1.0x1.5mm
L1: 4,7μH; L_0603_1608Metric
L2: 2,7nH; L_0201_0603Metric
L3, L4: 3,5nH; L_0201_0603Metric
Q1, Q2, Q3: AO3401A; SOT-23
R1, R7: 470k; R_0402_1005Metric
R2: 1M; R_0402_1005Metric
R3: 3,3k; R_0402_1005Metric
R4, R5: 10k; R_0402_1005Metric
R6, R9: 1k; R_0402_1005Metric
R8, R10: 0R; R_0402_1005Metric
SW1: SW_SPDT; SSSS810701
SW2: SW_SPST; SW_TS-1088-AR02016
U1: nRF54L15-QFXX; QFN-48-1EP_6x6mm_P0.4mm_EP4.6x4.6mm
U2: BMI270; Bosch_LGA-14_3x2.5mm_P0.5mm
U3: STS4X
U4: LTR-329ALS-01; Lite-On_LTR-329ALS-01
Y1: 32MHz; Crystal_SMD_2016-4Pin_2.0x1.6mm
Y2: 32.768kHz; Crystal_SMD_3215-2Pin_3.2x1.5mm

Connections:
+3.3V: D1.2 (A), J1.1, J4.2, Q1.1 (G), R1.2
/Project Architecture/Section A - Title A/ANT: AE1.1 (A), C12.2, L4.2
/Project Architecture/Section A - Title A/BMI_INT1: U1.24 (P0.01), U2.4 (INT1)
/Project Architecture/Section A - Title A/BMI_INT2: U1.27 (P0.02), U2.9 (INT2)
/Project Architecture/Section A - Title A/DCC: L1.1, U1.46 (DCC)
/Project Architecture/Section A - Title A/DECD: C9.1, FB1.1, L1.2, U1.45 (DECD)
/Project Architecture/Section A - Title A/DECRF: C6.1, C7.1, C8.1, FB1.2, U1.33 (DECRF), U1.43 (DECA)
/Project Architecture/Section A - Title A/NFC+: R8.1, U1.3 (P1.02)
/Project Architecture/Section A - Title A/NFC-: R10.1, U1.4 (P1.03)
/Project Architecture/Section A - Title A/P1.04: J2.1, U1.5 (P1.04)
/Project Architecture/Section A - Title A/P1.05: J2.2, U1.6 (P1.05)
/Project Architecture/Section A - Title A/P1.06: J2.3, U1.7 (P1.06)
/Project Architecture/Section A - Title A/P1.07: J2.4, U1.8 (P1.07)
/Project Architecture/Section A - Title A/P1.08: J2.5, U1.9 (P1.08)
/Project Architecture/Section A - Title A/P1.09: J2.6, U1.37 (P1.09)
/Project Architecture/Section A - Title A/P1.10: J2.7, U1.38 (P1.10)
/Project Architecture/Section A - Title A/P1.11: J2.8, U1.39 (P1.11)
/Project Architecture/Section A - Title A/P1.12: J2.9, U1.40 (P1.12)
/Project Architecture/Section A - Title A/P1.13: J2.10, U1.41 (P1.13)
/Project Architecture/Section A - Title A/P2.00: J4.8, U1.11 (P2.00)
/Project Architecture/Section A - Title A/P2.01: J4.7, U1.12 (P2.01)
/Project Architecture/Section A - Title A/P2.02: J4.6, U1.13 (P2.02)
/Project Architecture/Section A - Title A/P2.03: J4.5, U1.14 (P2.03)
/Project Architecture/Section A - Title A/P2.04: J4.4, U1.15 (P2.04)
/Project Architecture/Section A - Title A/P2.05: J4.3, U1.16 (P2.05)
/Project Architecture/Section A - Title A/PW_SW+: J4.9, Q3.2 (S), R7.1
/Project Architecture/Section A - Title A/PW_SW_OUT: J4.10, Q3.3 (D)
/Project Architecture/Section A - Title A/RF: L2.1, U1.31 (ANT)
/Project Architecture/Section A - Title A/RF': C10.2, L2.2, L3.1
/Project Architecture/Section A - Title A/RF'': C11.2, L3.2, L4.1
/Project Architecture/Section A - Title A/SCL: R4.1, U1.29 (P0.04), U2.13 (SCx), U3.2 (SCL), U4.4 (SCL)
/Project Architecture/Section A - Title A/SDA: R5.1, U1.28 (P0.03), U2.14 (SDx), U3.1 (SDA), U4.3 (SDA)
/Project Architecture/Section A - Title A/SWCLK: J3.4 (SWCLK/TCK), U1.26 (SWDCLK)
/Project Architecture/Section A - Title A/SWDIO: J3.2 (SWDIO/TMS), U1.25 (SWDIO)
/Project Architecture/Section A - Title A/USER_LED: D2.2 (A), U1.19 (P2.08)
/Project Architecture/Section A - Title A/USER_SW: C18.2, R9.2, U1.42 (P1.14)
/Project Architecture/Section A - Title A/VBat: BT1.1 (+), Q1.3 (D)
/Project Architecture/Section A - Title A/VDD': D1.1 (K), JP1.1 (A), Q1.2 (S), SW1.2 (B)
/Project Architecture/Section A - Title A/~PW_SW_EN: Q3.1 (G), R7.2, U1.17 (P2.06)
/Project Architecture/Section A - Title A/~RST_Conn: J3.10 (~RESET), R6.2
/Project Architecture/Section A - Title A/~RST: C14.1, R6.1, U1.30 (~RESET)
/Project Architecture/Section A - Title A/~VDD_susp_EN: Q2.1 (G), R2.1, U1.23 (P0.00)
GND: AE1.2, BT1.2 (-), C1.2, C2.2, C3.2, C4.2, C5.2, C6.2, C7.2, C8.2, C9.2, C10.1, C11.1, C12.1, C13.2, C14.2, C15.2, C16.2, C17.2, C18.1, C19.2, J1.2, J1.MP (MountPin), J3.3 (GND), J3.5 (GND), J3.9 (GNDDetect), J4.1, J5.MP (MountPin), R1.1, R3.1, SW1.MP (C), SW2.1 (A), U1.32 (VSS_PA), U1.44 (VSS), U1.49 (VSS), U2.1 (SDO), U2.6 (GNDIO), U2.7 (GND), U3.4 (VSS), U4.2 (GND), Y1.2, Y1.4
unnamed: D2.1 (K), R3.2
unnamed: C19.1, J5.2, R8.2
unnamed: C17.1, J5.4, R10.2
unnamed: R9.1, SW2.2 (B)
unnamed: U1.1 (P1.00), Y2.2
unnamed: U1.2 (P1.01), Y2.1
unnamed: U1.34 (XC1), Y1.3
unnamed: U1.35 (XC2), Y1.1
VDD: C1.1, C2.1, C3.1, C4.1, C5.1, J3.1 (VTref), JP1.2 (B), Q2.2 (S), R2.2, SW1.3 (C), U1.10 (VDD), U1.22 (VDD), U1.36 (VDD), U1.47 (VDD), U1.48 (VDD)
VDD_susp: C13.1, C15.1, C16.1, Q2.3 (D), R4.2, R5.2, U2.5 (VDDIO), U2.8 (VDD), U2.12 (CSB), U3.3 (VDD), U4.1 (VDD)
