GoodByte-Hardware/BTZ-EndDevice/(notices)

Notices in the files:
README.md:
License: MIT
